ducsuibot/FPGA-Based-Driver-Drowsiness-Detection-using-BNN-Kiwi-1P5-Sonix-MCU/MCU_Sonix_Buzzer_WD/Source/Readme/readme.txt

/*
struct tree
	main.c: initial and main loop function
	PFPA.c: unused
	GPIO.c: initial gpio pin
	 WDT.c: initial watchdog with 250ms reset while do nothing
 utility.c: delay to set digital tube scan freuqency

 Segment.c: driver digital tube functions
 
 function:
	segment tube display "3210"
*/
