ducsuibot/FPGA-Based-Driver-Drowsiness-Detection-using-BNN-Kiwi-1P5-Sonix-MCU/Gowin_ROM.v

//Copyright (C)2014-2026 Gowin Semiconductor Corporation.
//All rights reserved.
//File Title: IP file
//Tool Version: V1.9.12.02_SP1 (64-bit)
//IP Version: 1.0
//Part Number: GW1N-LV1P5LQ100C6/I5
//Device: GW1N-1P5
//Created Time: Sun Apr 26 16:49:59 2026

module Gowin_ROM (dout, clk, oce, ce, reset, ad);

output [31:0] dout;
input clk;
input oce;
input ce;
input reset;
input [10:0] ad;

wire lut_f_0;
wire lut_f_1;
wire [15:0] prom_inst_0_dout_w;
wire [15:0] prom_inst_0_dout;
wire [15:0] prom_inst_1_dout_w;
wire [31:16] prom_inst_1_dout;
wire [31:0] prom_inst_2_dout;
wire dff_q_0;
wire gw_gnd;

assign gw_gnd = 1'b0;

LUT2 lut_inst_0 (
  .F(lut_f_0),
  .I0(ce),
  .I1(ad[10])
);
defparam lut_inst_0.INIT = 4'h2;
LUT3 lut_inst_1 (
  .F(lut_f_1),
  .I0(ce),
  .I1(ad[9]),
  .I2(ad[10])
);
defparam lut_inst_1.INIT = 8'h20;
pROM prom_inst_0 (
    .DO({prom_inst_0_dout_w[15:0],prom_inst_0_dout[15:0]}),
    .CLK(clk),
    .OCE(oce),
    .CE(lut_f_0),
    .RESET(reset),
    .AD({ad[9:0],gw_gnd,gw_gnd,gw_gnd,gw_gnd})
);

defparam prom_inst_0.READ_MODE = 1'b0;
defparam prom_inst_0.BIT_WIDTH = 16;
defparam prom_inst_0.RESET_MODE = "SYNC";
defparam prom_inst_0.INIT_RAM_00 = 256'hFFF0FE87FF69FE08FE16FF88FFB2FF01FE15FEFFFFD9FF47FE88FFBDFFF0FF78;
defparam prom_inst_0.INIT_RAM_01 = 256'h8003FED9FFBAFE0FFE12FFDEFE79FF33FE92FEFFFE1BFFB0FE37FEDEFE4BFEC0;
defparam prom_inst_0.INIT_RAM_02 = 256'h808BFF04FF90FE00FF29FE90FFE0FFA8FF14FFAFFF19FEA6FE80FFCFFE6DFF59;
defparam prom_inst_0.INIT_RAM_03 = 256'h809BFF58FF39FE2FFE2AFFB7FEBBFE27FE55FEF8FF33FEB3FEAFFFBBFF1FFF58;
defparam prom_inst_0.INIT_RAM_04 = 256'h8000FE6BFE9AFED6FEDDFE9FFEFFFE40FFD8FFFBFE10FF5EFE0EFE99FE80FEAE;
defparam prom_inst_0.INIT_RAM_05 = 256'h80DAFE32FEF5FEF4FF3DFF17FE66FFA5FF26FE08FECAFF24FE26FEFBFECBFEEE;
defparam prom_inst_0.INIT_RAM_06 = 256'h81EBFEA0FF00FF11FF39FF82FF27FE87FE00FF1EFECAFE20FE31FF3EFFCEFFCD;
defparam prom_inst_0.INIT_RAM_07 = 256'h8186FEC8FF09FF3FFE55FE43FF07FE43FE09FF4CFFCEFE20FEE3FE1CFF1EFF8B;
defparam prom_inst_0.INIT_RAM_08 = 256'h80F1FE1AFE42FFDEFF2FFE07FE25FF60FE0EFE40FEE1FF0AFE17FE23FEFAFEE3;
defparam prom_inst_0.INIT_RAM_09 = 256'h80C8FF11FED6FE18FF89FF87FE65FFA4FF17FE62FEC1FF32FE0BFEC3FE4AFECB;
defparam prom_inst_0.INIT_RAM_0A = 256'h8017FE91FEC7FE17FE85FE38FF20FE87FFC7FE78FF68FEE2FE1EFFF8FE1FFE8A;
defparam prom_inst_0.INIT_RAM_0B = 256'h8088FFB6FF20FF00FEB9FF97FE9FFF39FE31FF96FF08FF77FFABFEDDFE00FFB9;
defparam prom_inst_0.INIT_RAM_0C = 256'h8080FE75FED7FEC0FEABFEAFFE07FE4DFF85FE08FE40FE36FE57FE69FED9FE2F;
defparam prom_inst_0.INIT_RAM_0D = 256'h81B4FE0CFE44FF6FFEECFFC6FE83FED8FF5CFFA1FFA0FE4EFE57FE81FFDCFFA5;
defparam prom_inst_0.INIT_RAM_0E = 256'h80C1FFA3FF80FF29FE21FF87FE05FF32FE21FE19FF89FE24FF0BFE15FFC8FE5B;
defparam prom_inst_0.INIT_RAM_0F = 256'h81B7FE83FFC6FE21FE2FFF83FFDBFE49FE09FE32FF96FE24FEBAFFD7FFCAFFC3;
defparam prom_inst_0.INIT_RAM_10 = 256'h81CEFE18FF11FE23FF28FF02FF47FE83FE01FFBEFF88FE21FEABFF3EFFCEFF0B;
defparam prom_inst_0.INIT_RAM_11 = 256'h402628926D9C165039C8C80CE0C4604BEF13F93BC06AE46DC072E072402ED277;
defparam prom_inst_0.INIT_RAM_12 = 256'h0B9C0800580E5AF8FA039BD57D981C11CAE58E6C82F5A2EF2C6214000DABF0EA;
defparam prom_inst_0.INIT_RAM_13 = 256'h4626E457B77C15DE478C56654F9439CDBF89BF89CC92288001BA5898507B78DA;
defparam prom_inst_0.INIT_RAM_14 = 256'h2FBD8E0D160FE4EEECAAEE927D185D985289AFEF5644A7553B9DD7ECE264ABFB;
defparam prom_inst_0.INIT_RAM_15 = 256'hC4734D8BE066507212671247812CE679FE64B777BB7ED76EB2EE11EF9AB2EE9F;
defparam prom_inst_0.INIT_RAM_16 = 256'h49DB0F9D5BFFA26E22135F043081FDA00FBBCD8B1EB8BF94BC72F2EF8AC6AA4C;
defparam prom_inst_0.INIT_RAM_17 = 256'h46335165437CE77F01D30098508B40AA4F9C0EC040457870736FDBF3D3F00393;
defparam prom_inst_0.INIT_RAM_18 = 256'h2DF7048099B8192AE4E32C12299A04C019983B40E86340221142B5BA802A9662;
defparam prom_inst_0.INIT_RAM_19 = 256'h019A1998010909110D1B4A50705D1A61704239F0E1B4A99102568A6F92E7A267;
defparam prom_inst_0.INIT_RAM_1A = 256'hC422281A5E99B24039981900A5A80290C34BED73F269F71B45765164427FC677;
defparam prom_inst_0.INIT_RAM_1B = 256'h5D1C0640714C1F5154C63BF293F5811134D532EDC267E267B4761E002D99148A;
defparam prom_inst_0.INIT_RAM_1C = 256'h39C84380E8966200385BBDD2A8E3BFFB48F228F6AAEDDFF70190191840091C00;
defparam prom_inst_0.INIT_RAM_1D = 256'hD06671F2A5F01B192A57976D826FA267AD76149835B8DC2BE46264123D9B94C8;
defparam prom_inst_0.INIT_RAM_1E = 256'h574C52654D9A098A3989BF893E93398057D75ACF428D2A8D5D185A59C01C1969;
defparam prom_inst_0.INIT_RAM_1F = 256'hD83AEE106D985D98DBC9FBFFE247E2753B9CBBFCF6656BBF4E67A7F79576B5A5;
defparam prom_inst_0.INIT_RAM_20 = 256'hB649B61B50130000FE67EFE7BFF4F36DA2FBF9FF9EEAE49FADBC840F164B66EE;
defparam prom_inst_0.INIT_RAM_21 = 256'h5F88EBE356C6A6553F9D1BF4C567EBB3C6477DD5777135EE568C02656754917C;
defparam prom_inst_0.INIT_RAM_22 = 256'hA820B520BD6AD17AF2EE65A48EFAE58E2FBD8C0D0E0BFDE6DB3BE9917D985D98;
defparam prom_inst_0.INIT_RAM_23 = 256'hCCE32C123D9B104439D9AA8A485762B9A97AFDB2A46FB651407A4064332DE677;
defparam prom_inst_0.INIT_RAM_24 = 256'h5D185A00F9071178D04271F2C1F0BA1122470AED92E7A2672477109035B91FAA;
defparam prom_inst_0.INIT_RAM_25 = 256'h6AA7E5FFB71DBDD450A680847F987F981F88BF88FC920B820193190840890C91;
defparam prom_inst_0.INIT_RAM_26 = 256'h2FBDAC0D1E4F946EFCA870927D885D98D28DAB7FDA47E364135D13F5A2E4A1FB;
defparam prom_inst_0.INIT_RAM_27 = 256'h1C3457CD0ADC09823D889F893E832988FE2CE7E7FF64F77CE6ECA5BF8EBAE78F;
defparam prom_inst_0.INIT_RAM_28 = 256'hDABA68937D985D9858C8FFFFE666E5B53B5C53FDE67449BB4667EFFF156F55F7;
defparam prom_inst_0.INIT_RAM_29 = 256'h37197711977DC667FE6DEEE7BFE4F777F6E3F5BF92E6AC3F8DBC8C0F2E7EA46E;
defparam prom_inst_0.INIT_RAM_2A = 256'hF6E71186B199B91A4C82C8B29C3B42D43D987F2DAE6F6D59FCBB499AB4697609;
defparam prom_inst_0.INIT_RAM_2B = 256'h01FB1898408940C9671CE784F0531868F0667BF201E6AAF30B1D8366826FE667;
defparam prom_inst_0.INIT_RAM_2C = 256'h3B9D13ECC2E4E9BB4227673B9760B795562702655F914984998DBF8B7C9219C0;
defparam prom_inst_0.INIT_RAM_2D = 256'hF2E6A9FF2E99E7BF2FBD8E0D0A4BA46EDD3AEE126D905D9842C8EFFBDF46E655;
defparam prom_inst_0.INIT_RAM_2E = 256'hC667D17FB7BC9D9EEC27A0C41FD649AC1F89BF87589A3984FE66B777BB7CD3EC;
defparam prom_inst_0.INIT_RAM_2F = 256'h0FB9CC2D000FD76E393844102D185998D649E9FFC6462A751FDCD3E4C0654FBB;
defparam prom_inst_0.INIT_RAM_30 = 256'h798D36450704D162A208E708A5033205FE67A66FB3EED2EEB2FFF8FD96E3E4BF;
defparam prom_inst_0.INIT_RAM_31 = 256'hD078ED307C885D98D28DAFF75F850DF51B5D93CDE056DE774686D75A371CFDD9;
defparam prom_inst_0.INIT_RAM_32 = 256'hFD980D983E9B3982A86AE5A8EDEAF8FBE2E6A5A4BAB6AC37AFB1A409264E8766;
defparam prom_inst_0.INIT_RAM_33 = 256'hDDEDE9FFCFF6404FD224B6D4F455B57B73942880771F1D1CDB9697E55FD8BF84;
defparam prom_inst_0.INIT_RAM_34 = 256'hFE2CC767FF740365B266E1BFA7F2879F8899AC0C6C0F606EE27EE6736D825D90;
defparam prom_inst_0.INIT_RAM_35 = 256'hC4E2251A1F9A5448B0181A48EA53A2422B90FCBBAAE7FAFE48F658F6AAEDDCBB;
defparam prom_inst_0.INIT_RAM_36 = 256'h51149CC968151841D042F3F2E1F16A992277DE6D9267A2678676041C0539594B;
defparam prom_inst_0.INIT_RAM_37 = 256'h34C831046284022CCA00AC3AA023E225C27FC0631268C67F76371BCF4A850B15;
defparam prom_inst_0.INIT_RAM_38 = 256'h904691F23B940B31AB4F434FC277A267150404001C9955CACC230CB22F1D1C01;
defparam prom_inst_0.INIT_RAM_39 = 256'h4C9B718BAAE7B8F6CAF6ABF5AEADFEFD01D35018588B4D995D1C1A80511C1868;
defparam prom_inst_0.INIT_RAM_3A = 256'h0206E9E58276E26283660598A239C263A2130C1ADFBBA058A108DA8660930002;
defparam prom_inst_0.INIT_RAM_3B = 256'hB9892F9808981988561E1B475B850E851D50581B3D111BC0B046F3C6A1B12999;
defparam prom_inst_0.INIT_RAM_3C = 256'h6080DF6FD767301E5300F2C4E0774FBBE6B7FFFFD7E9F467044C924C5BF5BEF3;
defparam prom_inst_0.INIT_RAM_3D = 256'hFF44B7F7F266C6FE8AE9E599E6E7EE2643B6AC3DDA4D65ECFC7F87A30D0B399D;
defparam prom_inst_0.INIT_RAM_3E = 256'hB25D935DF6672AF37E97491F358D9DDAD777424433102709B719970815181100;
defparam prom_inst_0.INIT_RAM_3F = 256'hF262A9B68FFBEE968DBDA60FAA4FE464F628F0322D905D984548EB77D6EEC275;

pROM prom_inst_1 (
    .DO({prom_inst_1_dout_w[15:0],prom_inst_1_dout[31:16]}),
    .CLK(clk),
    .OCE(oce),
    .CE(lut_f_0),
    .RESET(reset),
    .AD({ad[9:0],gw_gnd,gw_gnd,gw_gnd,gw_gnd})
);

defparam prom_inst_1.READ_MODE = 1'b0;
defparam prom_inst_1.BIT_WIDTH = 16;
defparam prom_inst_1.RESET_MODE = "SYNC";
defparam prom_inst_1.INIT_RAM_00 = 256'h8006800580058004800580048006800580058007800680058004800680068005;
defparam prom_inst_1.INIT_RAM_01 = 256'h4F45000000000000000000000000000000000000000000000000000000000000;
defparam prom_inst_1.INIT_RAM_02 = 256'h5545000000000000000000000000000000000000000000000000000000000000;
defparam prom_inst_1.INIT_RAM_03 = 256'h5546000000000000000000000000000000000000000000000000000000000000;
defparam prom_inst_1.INIT_RAM_04 = 256'h5044000000000000000000000000000000000000000000000000000000000000;
defparam prom_inst_1.INIT_RAM_05 = 256'h5145000000000000000000000000000000000000000000000000000000000000;
defparam prom_inst_1.INIT_RAM_06 = 256'h574A000000000000000000000000000000000000000000000000000000000000;
defparam prom_inst_1.INIT_RAM_07 = 256'h5146000000000000000000000000000000000000000000000000000000000000;
defparam prom_inst_1.INIT_RAM_08 = 256'h5144000000000000000000000000000000000000000000000000000000000000;
defparam prom_inst_1.INIT_RAM_09 = 256'h4E43000000000000000000000000000000000000000000000000000000000000;
defparam prom_inst_1.INIT_RAM_0A = 256'h5144000000000000000000000000000000000000000000000000000000000000;
defparam prom_inst_1.INIT_RAM_0B = 256'h5045000000000000000000000000000000000000000000000000000000000000;
defparam prom_inst_1.INIT_RAM_0C = 256'h4C40000000000000000000000000000000000000000000000000000000000000;
defparam prom_inst_1.INIT_RAM_0D = 256'h4F44000000000000000000000000000000000000000000000000000000000000;
defparam prom_inst_1.INIT_RAM_0E = 256'h5145000000000000000000000000000000000000000000000000000000000000;
defparam prom_inst_1.INIT_RAM_0F = 256'h5344000000000000000000000000000000000000000000000000000000000000;
defparam prom_inst_1.INIT_RAM_10 = 256'h5748000000000000000000000000000000000000000000000000000000000000;
defparam prom_inst_1.INIT_RAM_11 = 256'h8108810881088108810881088108810881088108810881088108810881088108;
defparam prom_inst_1.INIT_RAM_12 = 256'h8108810881088108810881088108810881088108810881088108810881088108;
defparam prom_inst_1.INIT_RAM_13 = 256'h8138813881388138813881388138813881388138813881388108810881088108;
defparam prom_inst_1.INIT_RAM_14 = 256'h8138813881388138813881388138813881388138813881388138813881388138;
defparam prom_inst_1.INIT_RAM_15 = 256'h8131813181318131813181318131813181388138813881388138813881388138;
defparam prom_inst_1.INIT_RAM_16 = 256'h8131813181318131813181318131813181318131813181318131813181318131;
defparam prom_inst_1.INIT_RAM_17 = 256'h80F880F880F880F8813181318131813181318131813181318131813181318131;
defparam prom_inst_1.INIT_RAM_18 = 256'h80F880F880F880F880F880F880F880F880F880F880F880F880F880F880F880F8;
defparam prom_inst_1.INIT_RAM_19 = 256'h80F880F880F880F880F880F880F880F880F880F880F880F880F880F880F880F8;
defparam prom_inst_1.INIT_RAM_1A = 256'h80F880F880F880F880F880F880F880F880F880F880F880F880F880F880F880F8;
defparam prom_inst_1.INIT_RAM_1B = 256'h80F880F880F880F880F880F880F880F880F880F880F880F880F880F880F880F8;
defparam prom_inst_1.INIT_RAM_1C = 256'h81188118811881188118811881188118811881188118811880F880F880F880F8;
defparam prom_inst_1.INIT_RAM_1D = 256'h8118811881188118811881188118811881188118811881188118811881188118;
defparam prom_inst_1.INIT_RAM_1E = 256'h8144814481448144814481448144814481188118811881188118811881188118;
defparam prom_inst_1.INIT_RAM_1F = 256'h8144814481448144814481448144814481448144814481448144814481448144;
defparam prom_inst_1.INIT_RAM_20 = 256'h8133813381338133814481448144814481448144814481448144814481448144;
defparam prom_inst_1.INIT_RAM_21 = 256'h8133813381338133813381338133813381338133813381338133813381338133;
defparam prom_inst_1.INIT_RAM_22 = 256'h8133813381338133813381338133813381338133813381338133813381338133;
defparam prom_inst_1.INIT_RAM_23 = 256'h8101810181018101810181018101810181018101810181018101810181018101;
defparam prom_inst_1.INIT_RAM_24 = 256'h8101810181018101810181018101810181018101810181018101810181018101;
defparam prom_inst_1.INIT_RAM_25 = 256'h8127812781278127812781278127812781278127812781278101810181018101;
defparam prom_inst_1.INIT_RAM_26 = 256'h8127812781278127812781278127812781278127812781278127812781278127;
defparam prom_inst_1.INIT_RAM_27 = 256'h8144814481448144814481448144814481278127812781278127812781278127;
defparam prom_inst_1.INIT_RAM_28 = 256'h8144814481448144814481448144814481448144814481448144814481448144;
defparam prom_inst_1.INIT_RAM_29 = 256'h8124812481248124814481448144814481448144814481448144814481448144;
defparam prom_inst_1.INIT_RAM_2A = 256'h8124812481248124812481248124812481248124812481248124812481248124;
defparam prom_inst_1.INIT_RAM_2B = 256'h8124812481248124812481248124812481248124812481248124812481248124;
defparam prom_inst_1.INIT_RAM_2C = 256'h8128812881288128812881288128812881288128812881288128812881288128;
defparam prom_inst_1.INIT_RAM_2D = 256'h8128812881288128812881288128812881288128812881288128812881288128;
defparam prom_inst_1.INIT_RAM_2E = 256'h814E814E814E814E814E814E814E814E814E814E814E814E8128812881288128;
defparam prom_inst_1.INIT_RAM_2F = 256'h814E814E814E814E814E814E814E814E814E814E814E814E814E814E814E814E;
defparam prom_inst_1.INIT_RAM_30 = 256'h81348134813481348134813481348134814E814E814E814E814E814E814E814E;
defparam prom_inst_1.INIT_RAM_31 = 256'h8134813481348134813481348134813481348134813481348134813481348134;
defparam prom_inst_1.INIT_RAM_32 = 256'h812A812A812A812A813481348134813481348134813481348134813481348134;
defparam prom_inst_1.INIT_RAM_33 = 256'h812A812A812A812A812A812A812A812A812A812A812A812A812A812A812A812A;
defparam prom_inst_1.INIT_RAM_34 = 256'h812A812A812A812A812A812A812A812A812A812A812A812A812A812A812A812A;
defparam prom_inst_1.INIT_RAM_35 = 256'h811B811B811B811B811B811B811B811B811B811B811B811B811B811B811B811B;
defparam prom_inst_1.INIT_RAM_36 = 256'h811B811B811B811B811B811B811B811B811B811B811B811B811B811B811B811B;
defparam prom_inst_1.INIT_RAM_37 = 256'h80F980F980F980F980F980F980F980F980F980F980F980F9811B811B811B811B;
defparam prom_inst_1.INIT_RAM_38 = 256'h80F980F980F980F980F980F980F980F980F980F980F980F980F980F980F980F9;
defparam prom_inst_1.INIT_RAM_39 = 256'h8113811381138113811381138113811380F980F980F980F980F980F980F980F9;
defparam prom_inst_1.INIT_RAM_3A = 256'h8113811381138113811381138113811381138113811381138113811381138113;
defparam prom_inst_1.INIT_RAM_3B = 256'h8145814581458145811381138113811381138113811381138113811381138113;
defparam prom_inst_1.INIT_RAM_3C = 256'h8145814581458145814581458145814581458145814581458145814581458145;
defparam prom_inst_1.INIT_RAM_3D = 256'h8145814581458145814581458145814581458145814581458145814581458145;
defparam prom_inst_1.INIT_RAM_3E = 256'h8128812881288128812881288128812881288128812881288128812881288128;
defparam prom_inst_1.INIT_RAM_3F = 256'h8128812881288128812881288128812881288128812881288128812881288128;

pROM prom_inst_2 (
    .DO(prom_inst_2_dout[31:0]),
    .CLK(clk),
    .OCE(oce),
    .CE(lut_f_1),
    .RESET(reset),
    .AD({ad[8:0],gw_gnd,gw_gnd,gw_gnd,gw_gnd,gw_gnd})
);

defparam prom_inst_2.READ_MODE = 1'b0;
defparam prom_inst_2.BIT_WIDTH = 32;
defparam prom_inst_2.RESET_MODE = "SYNC";
defparam prom_inst_2.INIT_RAM_00 = 256'h8110D076811020768110226F8110F67F8128A8688128E5308128A1728128F5E3;
defparam prom_inst_2.INIT_RAM_01 = 256'h81109DC88110E1AA8110EAA381104A658110ABDA81103DCF8110A2628110F474;
defparam prom_inst_2.INIT_RAM_02 = 256'h8110A577811054808110292B81105DAB8110C48281102C1281100A9A81105242;
defparam prom_inst_2.INIT_RAM_03 = 256'h8110D042811031F28110F1B581100B91811082578110D6E5811082EF8110A267;
defparam prom_inst_2.INIT_RAM_04 = 256'h8110207381101118811008898110089981101D9981105C508110E055811018C8;
defparam prom_inst_2.INIT_RAM_05 = 256'h813A1044813A0044813A7F98813A5989813A1D88813ADF98813ADC90813A0990;
defparam prom_inst_2.INIT_RAM_06 = 256'h813A1BFC813A936C813AE0F4813A687B813A6717813ADDBF813ABCD9813A1D95;
defparam prom_inst_2.INIT_RAM_07 = 256'h813AAC3A813AE533813A6D88813A5D98813AFAC8813AE17F813AE647813A65BD;
defparam prom_inst_2.INIT_RAM_08 = 256'h813AFEE3813AA9BF813A86FB813AA73E813AAD3F813AAC0F813A9E6F813AE66E;
defparam prom_inst_2.INIT_RAM_09 = 256'h812BAA89812BBF89812B2F92812B0B80813AFE24813AE6F7813AFEF6813AFBE6;
defparam prom_inst_2.INIT_RAM_0A = 256'h812B4E67812B4975812B1038812B154E812B5747812B8604812B5FD0812BAB8D;
defparam prom_inst_2.INIT_RAM_0B = 256'h812BD125812B8DFF812BDA66812BB6F5812B335D812BD7DD812BC474812B29FA;
defparam prom_inst_2.INIT_RAM_0C = 256'h812B2DBD812B2E0D812B4859812B2ECC812BFDA8812B6890812B2D18812B5D98;
defparam prom_inst_2.INIT_RAM_0D = 256'h812BFE64812BA767812BBF76812B92BF812B8B7B812B591F812B8AF2812BE59F;
defparam prom_inst_2.INIT_RAM_0E = 256'h8147C0A68147E665814767748147303A8147800081472704814780068147733F;
defparam prom_inst_2.INIT_RAM_0F = 256'h8147F11C814733D48147C7F78147FA778147EAF48147B12D8147B7778147D7FF;
defparam prom_inst_2.INIT_RAM_10 = 256'h81475FBD814790AB8147ED0381475D998147C16A8147EF77814733848147DFC4;
defparam prom_inst_2.INIT_RAM_11 = 256'h8147F6678147EDB48147AA7E8147619E8147EBFA8147A42D8147106E8147E5E6;
defparam prom_inst_2.INIT_RAM_12 = 256'h811B5EF6811B48F6811BA9E9811BEEBF8147A8688147F4208147FCA28147F5B2;
defparam prom_inst_2.INIT_RAM_13 = 256'h811BB998811B98CA811B4872811B28F1811BEBB8811BFCBB811BA8A3811BBFF3;
defparam prom_inst_2.INIT_RAM_14 = 256'h811BA73A811B4008811B219B811B7BAA811BCCE2811B2492811B2C9B811B5A88;
defparam prom_inst_2.INIT_RAM_15 = 256'h811BD046811B71F0811B81F1811B4999811B265E811B82ED811BD26F811BA2E7;
defparam prom_inst_2.INIT_RAM_16 = 256'h811B57DD811B5B5F811B429F811B2F87811B1D9D811B0649811B4D0C811B18F1;
defparam prom_inst_2.INIT_RAM_17 = 256'h812ABA94812AADB9812AAAEE812AC8FE812A68FE812A58F6812AD8EF812ADCFD;
defparam prom_inst_2.INIT_RAM_18 = 256'h812A84E6812A8932812ABD9F812AF00C812A31D9812AF3D0812AEA6B812AE2BD;
defparam prom_inst_2.INIT_RAM_19 = 256'h812A9E57812AD667812A83EF812AA2E7812A66A7812A6718812A3D99812A5D6A;
defparam prom_inst_2.INIT_RAM_1A = 256'h812A7D9C812A0EE9812A6D45812A19C0812AD243812A9BF2812A03E7812A8A39;
defparam prom_inst_2.INIT_RAM_1B = 256'h810000668100F47F8100C4688100E22F812A5797812A5ACF812A4A8D812A6FDD;
defparam prom_inst_2.INIT_RAM_1C = 256'h8100B8D981008A8A8100CAC381004262810082D68100642E8100827A8100A472;
defparam prom_inst_2.INIT_RAM_1D = 256'h810007BC81002400810034998100181B8100CC23810048B28100BA2881006001;
defparam prom_inst_2.INIT_RAM_1E = 256'h81007AC88100B3C58100FD95810060538100B4988100D6EF810082E78100A266;
defparam prom_inst_2.INIT_RAM_1F = 256'h810008108100015081000D5981000D108100099E810052468100391C81001BC9;
defparam prom_inst_2.INIT_RAM_20 = 256'h811037F68110AD9A811098A38110FEB5811048F6811048F781105AF38110CFFF;
defparam prom_inst_2.INIT_RAM_21 = 256'h8110806381102D1381103DA98110144C811039C88110C08881104BF2811043C6;
defparam prom_inst_2.INIT_RAM_22 = 256'h81102BD68110A8EF811082E78110A267811024B68110000881100D988110C08A;
defparam prom_inst_2.INIT_RAM_23 = 256'h81104D1081105A098110156D81101A698110F6428110DBD08110B99481101399;
defparam prom_inst_2.INIT_RAM_24 = 256'h813C1F89813CEF89813C5D92813C19D88110579F81104AC78110631D81106FD5;
defparam prom_inst_2.INIT_RAM_25 = 256'h813C66A7813CFEF7813C3D50813CBD52813C546D813C80A8813C7F99813C3B81;
defparam prom_inst_2.INIT_RAM_26 = 256'h813C5380813CC36F813CDA65813C1355813C3BD9813CD7ED813CC444813C6FBF;
defparam prom_inst_2.INIT_RAM_27 = 256'h813C4D9D813C660D813CCC5A813CCF6E813C79B9813C3910813C3D08813C5D18;
defparam prom_inst_2.INIT_RAM_28 = 256'h813CFEEC813CA777813CB766813CF736813CFEE6813CA3FF813CBFAA813CE7BE;
defparam prom_inst_2.INIT_RAM_29 = 256'h81180F228118FDDB8118B02E81180045811865778118E66F8118F76F8118C77F;
defparam prom_inst_2.INIT_RAM_2A = 256'h8118C4E28118A08281183C9A8118468081185DD981188C288118882281184A42;
defparam prom_inst_2.INIT_RAM_2B = 256'h8118005C8118256F811892ED8118A2E78118AE328118448081188DB981187CB0;
defparam prom_inst_2.INIT_RAM_2C = 256'h8118090C81184A028118F555811839798118564E811819D0811889B08118DB91;
defparam prom_inst_2.INIT_RAM_2D = 256'h81035267810340738103372D8103873B811809D3811801C88118000B8118181B;
defparam prom_inst_2.INIT_RAM_2E = 256'h81033D988103BF8C81036AB58103424981032B988103098A8103A06A81039477;
defparam prom_inst_2.INIT_RAM_2F = 256'h8103087781031C8081032D3881031D8A8103C0238103AC1A81032D9881031400;
defparam prom_inst_2.INIT_RAM_30 = 256'h8103D243810339D2810359B18103CA53810326448103FEED810392FF8103A267;
defparam prom_inst_2.INIT_RAM_31 = 256'h8103019B81031990810340918103608181034484810386E08103F10581031BC0;
defparam prom_inst_2.INIT_RAM_32 = 256'h000000000000000000000000000000000000000000000000801021D88010F6C2;

DFFE dff_inst_0 (
  .Q(dff_q_0),
  .D(ad[10]),
  .CLK(clk),
  .CE(ce)
);
MUX2 mux_inst_2 (
  .O(dout[0]),
  .I0(prom_inst_0_dout[0]),
  .I1(prom_inst_2_dout[0]),
  .S0(dff_q_0)
);
MUX2 mux_inst_5 (
  .O(dout[1]),
  .I0(prom_inst_0_dout[1]),
  .I1(prom_inst_2_dout[1]),
  .S0(dff_q_0)
);
MUX2 mux_inst_8 (
  .O(dout[2]),
  .I0(prom_inst_0_dout[2]),
  .I1(prom_inst_2_dout[2]),
  .S0(dff_q_0)
);
MUX2 mux_inst_11 (
  .O(dout[3]),
  .I0(prom_inst_0_dout[3]),
  .I1(prom_inst_2_dout[3]),
  .S0(dff_q_0)
);
MUX2 mux_inst_14 (
  .O(dout[4]),
  .I0(prom_inst_0_dout[4]),
  .I1(prom_inst_2_dout[4]),
  .S0(dff_q_0)
);
MUX2 mux_inst_17 (
  .O(dout[5]),
  .I0(prom_inst_0_dout[5]),
  .I1(prom_inst_2_dout[5]),
  .S0(dff_q_0)
);
MUX2 mux_inst_20 (
  .O(dout[6]),
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
  .I1(prom_inst_2_dout[29]),
  .S0(dff_q_0)
);
MUX2 mux_inst_92 (
  .O(dout[30]),
  .I0(prom_inst_1_dout[30]),
  .I1(prom_inst_2_dout[30]),
  .S0(dff_q_0)
);
MUX2 mux_inst_95 (
  .O(dout[31]),
  .I0(prom_inst_1_dout[31]),
  .I1(prom_inst_2_dout[31]),
  .S0(dff_q_0)
);
endmodule //Gowin_ROM
