ducsuibot/FPGA-Based-Driver-Drowsiness-Detection-using-BNN-Kiwi-1P5-Sonix-MCU/RTL_EYE/weight_rom.v

// // `timescale 1ns / 1ps
// //
// // module weight_rom (
// //     input  wire        clk,
// //     input  wire [11:0] addr, 
// //     output reg  [31:0] data  
// // );
// //     reg [31:0] flash_mem [0:1425];
// //
// //     initial begin
// //         $readmemh("bnn_weights_sim.txt", flash_mem);
// //     end
// //
// //     always @(posedge clk) begin
// //         data <= flash_mem[addr];
// //     end
// //
// // endmodule
// //
// //
`timescale 1ns / 1ps

module weight_rom (
   input  wire        clk,
   input  wire [11:0] addr, 
   output wire [31:0] data  // Đổi thành wire vì data được lái bởi IP Core
);

   // Gọi IP Core pROM của Gowin vừa tạo
   // (Kiểm tra file gowin_prom.v được sinh ra để xem chính xác tên cổng)
   gowin_rom u_gowin_prom (
       .clk(clk),
       .oce(1'b1),     // Output Clock Enable (Luôn bật)
       .ce(1'b1),      // Chip Enable (Luôn bật)
       .reset(1'b0),   // Không dùng reset
       .ad(addr[10:0]),       // Địa chỉ 12-bit
       .dout(data)     // Dữ liệu đầu ra 32-bit (đã có sẵn độ trễ 1 chu kỳ)
   );

endmodule

//  `timescale 1ns / 1ps

//  module weight_rom (
//      input  wire        clk,
//      input  wire [11:0] addr, 
//      output reg  [31:0] data  
//  );

//      always @(posedge clk) begin
//          case (addr)
//              12'd0   : data <= 32'h8005FF17;
//              12'd1   : data <= 32'h8005FF70;
//              12'd2   : data <= 32'h8006FE28;
//              12'd3   : data <= 32'h8006FEF8;
//              12'd4   : data <= 32'h8005FEDF;
//              12'd5   : data <= 32'h8006FECE;
//              12'd6   : data <= 32'h8006FFD8;
//              12'd7   : data <= 32'h8006FFB7;
//              12'd8   : data <= 32'h8006FF75;
//              12'd9   : data <= 32'h8005FE1A;
//              12'd10  : data <= 32'h8006FFF8;
//              12'd11  : data <= 32'h8005FFEB;
//              12'd12  : data <= 32'h8006FFC0;
//              12'd13  : data <= 32'h8006FFE4;
//              12'd14  : data <= 32'h8005FEC2;
//              12'd15  : data <= 32'h8006FFF7;
//              12'd16  : data <= 32'h0000FF41;
//              12'd17  : data <= 32'h0000FF90;
//              12'd18  : data <= 32'h0000FF48;
//              12'd19  : data <= 32'h0000FEF5;
//              12'd20  : data <= 32'h0000FEB6;
//              12'd21  : data <= 32'h0000FF3C;
//              12'd22  : data <= 32'h0000FFF4;
//              12'd23  : data <= 32'h0000FFB8;
//              12'd24  : data <= 32'h0000FEF2;
//              12'd25  : data <= 32'h0000FE60;
//              12'd26  : data <= 32'h0000FF92;
//              12'd27  : data <= 32'h0000FFE6;
//              12'd28  : data <= 32'h0000FE88;
//              12'd29  : data <= 32'h0000FEC8;
//              12'd30  : data <= 32'h0000FEE8;
//              12'd31  : data <= 32'h514481F0;
//              12'd32  : data <= 32'h0000FF93;
//              12'd33  : data <= 32'h0000FE00;
//              12'd34  : data <= 32'h0000FEDB;
//              12'd35  : data <= 32'h0000FE3C;
//              12'd36  : data <= 32'h0000FF21;
//              12'd37  : data <= 32'h0000FF0B;
//              12'd38  : data <= 32'h0000FF96;
//              12'd39  : data <= 32'h0000FF03;
//              12'd40  : data <= 32'h0000FF93;
//              12'd41  : data <= 32'h0000FE8F;
//              12'd42  : data <= 32'h0000FF3C;
//              12'd43  : data <= 32'h0000FFB6;
//              12'd44  : data <= 32'h0000FEBD;
//              12'd45  : data <= 32'h0000FE0F;
//              12'd46  : data <= 32'h0000FE9E;
//              12'd47  : data <= 32'h4E468187;
//              12'd48  : data <= 32'h0000FF25;
//              12'd49  : data <= 32'h0000FE03;
//              12'd50  : data <= 32'h0000FE87;
//              12'd51  : data <= 32'h0000FE0C;
//              12'd52  : data <= 32'h0000FE48;
//              12'd53  : data <= 32'h0000FE59;
//              12'd54  : data <= 32'h0000FE68;
//              12'd55  : data <= 32'h0000FF41;
//              12'd56  : data <= 32'h0000FF24;
//              12'd57  : data <= 32'h0000FF80;
//              12'd58  : data <= 32'h0000FE68;
//              12'd59  : data <= 32'h0000FE4C;
//              12'd60  : data <= 32'h0000FF86;
//              12'd61  : data <= 32'h0000FF3B;
//              12'd62  : data <= 32'h0000FF95;
//              12'd63  : data <= 32'h50468063;
//              12'd64  : data <= 32'h0000FEA8;
//              12'd65  : data <= 32'h0000FEE3;
//              12'd66  : data <= 32'h0000FEC8;
//              12'd67  : data <= 32'h0000FF84;
//              12'd68  : data <= 32'h0000FF11;
//              12'd69  : data <= 32'h0000FE0C;
//              12'd70  : data <= 32'h0000FF87;
//              12'd71  : data <= 32'h0000FEB9;
//              12'd72  : data <= 32'h0000FF8B;
//              12'd73  : data <= 32'h0000FE6E;
//              12'd74  : data <= 32'h0000FF87;
//              12'd75  : data <= 32'h0000FF86;
//              12'd76  : data <= 32'h0000FE63;
//              12'd77  : data <= 32'h0000FECA;
//              12'd78  : data <= 32'h0000FEFB;
//              12'd79  : data <= 32'h52478183;
//              12'd80  : data <= 32'h0000FE38;
//              12'd81  : data <= 32'h0000FEE3;
//              12'd82  : data <= 32'h0000FF11;
//              12'd83  : data <= 32'h0000FF47;
//              12'd84  : data <= 32'h0000FE06;
//              12'd85  : data <= 32'h0000FE1E;
//              12'd86  : data <= 32'h0000FECA;
//              12'd87  : data <= 32'h0000FE1A;
//              12'd88  : data <= 32'h0000FEDE;
//              12'd89  : data <= 32'h0000FE2C;
//              12'd90  : data <= 32'h0000FF83;
//              12'd91  : data <= 32'h0000FFDE;
//              12'd92  : data <= 32'h0000FE2B;
//              12'd93  : data <= 32'h0000FE4B;
//              12'd94  : data <= 32'h0000FE11;
//              12'd95  : data <= 32'h524580CE;
//              12'd96  : data <= 32'h0000FEB3;
//              12'd97  : data <= 32'h0000FE7D;
//              12'd98  : data <= 32'h0000FE5E;
//              12'd99  : data <= 32'h0000FFA1;
//              12'd100 : data <= 32'h0000FF2D;
//              12'd101 : data <= 32'h0000FE00;
//              12'd102 : data <= 32'h0000FFA7;
//              12'd103 : data <= 32'h0000FF3B;
//              12'd104 : data <= 32'h0000FF91;
//              12'd105 : data <= 32'h0000FE09;
//              12'd106 : data <= 32'h0000FFA3;
//              12'd107 : data <= 32'h0000FFA6;
//              12'd108 : data <= 32'h0000FE7C;
//              12'd109 : data <= 32'h0000FE44;
//              12'd110 : data <= 32'h0000FEDF;
//              12'd111 : data <= 32'h54498121;
//              12'd112 : data <= 32'h0000FFE0;
//              12'd113 : data <= 32'h0000FE7B;
//              12'd114 : data <= 32'h0000FEC0;
//              12'd115 : data <= 32'h0000FF69;
//              12'd116 : data <= 32'h0000FE58;
//              12'd117 : data <= 32'h0000FE5C;
//              12'd118 : data <= 32'h0000FE28;
//              12'd119 : data <= 32'h0000FEE0;
//              12'd120 : data <= 32'h0000FF48;
//              12'd121 : data <= 32'h0000FE67;
//              12'd122 : data <= 32'h0000FE79;
//              12'd123 : data <= 32'h0000FE7C;
//              12'd124 : data <= 32'h0000FE3B;
//              12'd125 : data <= 32'h0000FE1C;
//              12'd126 : data <= 32'h0000FE26;
//              12'd127 : data <= 32'h55468040;
//              12'd128 : data <= 32'h0000FE0B;
//              12'd129 : data <= 32'h0000FE5A;
//              12'd130 : data <= 32'h0000FE59;
//              12'd131 : data <= 32'h0000FF42;
//              12'd132 : data <= 32'h0000FEB6;
//              12'd133 : data <= 32'h0000FF8B;
//              12'd134 : data <= 32'h0000FFA2;
//              12'd135 : data <= 32'h0000FFA7;
//              12'd136 : data <= 32'h0000FFF3;
//              12'd137 : data <= 32'h0000FE1B;
//              12'd138 : data <= 32'h0000FEE2;
//              12'd139 : data <= 32'h0000FFA5;
//              12'd140 : data <= 32'h0000FE4C;
//              12'd141 : data <= 32'h0000FE59;
//              12'd142 : data <= 32'h0000FE4A;
//              12'd143 : data <= 32'h53468172;
//              12'd144 : data <= 32'h0000FEFD;
//              12'd145 : data <= 32'h0000FFC5;
//              12'd146 : data <= 32'h0000FFB4;
//              12'd147 : data <= 32'h0000FEDB;
//              12'd148 : data <= 32'h0000FE99;
//              12'd149 : data <= 32'h0000FEDE;
//              12'd150 : data <= 32'h0000FE63;
//              12'd151 : data <= 32'h0000FE48;
//              12'd152 : data <= 32'h0000FE48;
//              12'd153 : data <= 32'h0000FEFF;
//              12'd154 : data <= 32'h0000FE73;
//              12'd155 : data <= 32'h0000FEF3;
//              12'd156 : data <= 32'h0000FFE6;
//              12'd157 : data <= 32'h0000FE6E;
//              12'd158 : data <= 32'h0000FE86;
//              12'd159 : data <= 32'h51458048;
//              12'd160 : data <= 32'h0000FF64;
//              12'd161 : data <= 32'h0000FE37;
//              12'd162 : data <= 32'h0000FF06;
//              12'd163 : data <= 32'h0000FE68;
//              12'd164 : data <= 32'h0000FE58;
//              12'd165 : data <= 32'h0000FE48;
//              12'd166 : data <= 32'h0000FE6D;
//              12'd167 : data <= 32'h0000FE40;
//              12'd168 : data <= 32'h0000FE2C;
//              12'd169 : data <= 32'h0000FF83;
//              12'd170 : data <= 32'h0000FE4D;
//              12'd171 : data <= 32'h0000FE48;
//              12'd172 : data <= 32'h0000FE17;
//              12'd173 : data <= 32'h0000FF3F;
//              12'd174 : data <= 32'h0000FF94;
//              12'd175 : data <= 32'h51448042;
//              12'd176 : data <= 32'h0000FE6A;
//              12'd177 : data <= 32'h0000FE66;
//              12'd178 : data <= 32'h0000FE66;
//              12'd179 : data <= 32'h0000FE03;
//              12'd180 : data <= 32'h0000FE9B;
//              12'd181 : data <= 32'h0000FE57;
//              12'd182 : data <= 32'h0000FE83;
//              12'd183 : data <= 32'h0000FE88;
//              12'd184 : data <= 32'h0000FEC9;
//              12'd185 : data <= 32'h0000FE7E;
//              12'd186 : data <= 32'h0000FE01;
//              12'd187 : data <= 32'h0000FFDB;
//              12'd188 : data <= 32'h0000FF66;
//              12'd189 : data <= 32'h0000FE44;
//              12'd190 : data <= 32'h0000FE4E;
//              12'd191 : data <= 32'h574A80C8;
//              12'd192 : data <= 32'h0000FFA8;
//              12'd193 : data <= 32'h0000FF78;
//              12'd194 : data <= 32'h0000FFA7;
//              12'd195 : data <= 32'h0000FE73;
//              12'd196 : data <= 32'h0000FFC8;
//              12'd197 : data <= 32'h0000FED4;
//              12'd198 : data <= 32'h0000FE6A;
//              12'd199 : data <= 32'h0000FFEA;
//              12'd200 : data <= 32'h0000FE70;
//              12'd201 : data <= 32'h0000FE87;
//              12'd202 : data <= 32'h0000FE71;
//              12'd203 : data <= 32'h0000FE6D;
//              12'd204 : data <= 32'h0000FE3B;
//              12'd205 : data <= 32'h0000FF74;
//              12'd206 : data <= 32'h0000FE22;
//              12'd207 : data <= 32'h50448066;
//              12'd208 : data <= 32'h0000FE83;
//              12'd209 : data <= 32'h0000FE61;
//              12'd210 : data <= 32'h0000FE2A;
//              12'd211 : data <= 32'h0000FFF0;
//              12'd212 : data <= 32'h0000FEB0;
//              12'd213 : data <= 32'h0000FE22;
//              12'd214 : data <= 32'h0000FE3A;
//              12'd215 : data <= 32'h0000FE19;
//              12'd216 : data <= 32'h0000FFC0;
//              12'd217 : data <= 32'h0000FE2F;
//              12'd218 : data <= 32'h0000FEF4;
//              12'd219 : data <= 32'h0000FF92;
//              12'd220 : data <= 32'h0000FE4D;
//              12'd221 : data <= 32'h0000FE70;
//              12'd222 : data <= 32'h0000FE36;
//              12'd223 : data <= 32'h54478097;
//              12'd224 : data <= 32'h0000FE43;
//              12'd225 : data <= 32'h0000FE4D;
//              12'd226 : data <= 32'h0000FE8B;
//              12'd227 : data <= 32'h0000FFDE;
//              12'd228 : data <= 32'h0000FFD6;
//              12'd229 : data <= 32'h0000FE3C;
//              12'd230 : data <= 32'h0000FE59;
//              12'd231 : data <= 32'h0000FEC1;
//              12'd232 : data <= 32'h0000FE46;
//              12'd233 : data <= 32'h0000FF8D;
//              12'd234 : data <= 32'h0000FFDE;
//              12'd235 : data <= 32'h0000FE08;
//              12'd236 : data <= 32'h0000FEEB;
//              12'd237 : data <= 32'h0000FE4F;
//              12'd238 : data <= 32'h0000FE0F;
//              12'd239 : data <= 32'h5044804E;
//              12'd240 : data <= 32'h0000FFE1;
//              12'd241 : data <= 32'h0000FFC6;
//              12'd242 : data <= 32'h0000FFA2;
//              12'd243 : data <= 32'h0000FE5B;
//              12'd244 : data <= 32'h0000FED9;
//              12'd245 : data <= 32'h0000FF83;
//              12'd246 : data <= 32'h0000FE79;
//              12'd247 : data <= 32'h0000FFC9;
//              12'd248 : data <= 32'h0000FE45;
//              12'd249 : data <= 32'h0000FF34;
//              12'd250 : data <= 32'h0000FF7B;
//              12'd251 : data <= 32'h0000FE3B;
//              12'd252 : data <= 32'h0000FF37;
//              12'd253 : data <= 32'h0000FF87;
//              12'd254 : data <= 32'h0000FF07;
//              12'd255 : data <= 32'h4D418048;
//              12'd256 : data <= 32'h0000FE5B;
//              12'd257 : data <= 32'h0000FE55;
//              12'd258 : data <= 32'h0000FFEE;
//              12'd259 : data <= 32'h0000FF23;
//              12'd260 : data <= 32'h0000FE03;
//              12'd261 : data <= 32'h0000FF8A;
//              12'd262 : data <= 32'h0000FE31;
//              12'd263 : data <= 32'h0000FE0F;
//              12'd264 : data <= 32'h0000FE49;
//              12'd265 : data <= 32'h0000FF69;
//              12'd266 : data <= 32'h0000FF03;
//              12'd267 : data <= 32'h0000FE3B;
//              12'd268 : data <= 32'h0000FE02;
//              12'd269 : data <= 32'h0000FE08;
//              12'd270 : data <= 32'h0000FE62;
//              12'd271 : data <= 32'h55498081;
//              12'd272 : data <= 32'h811F7FCB;
//              12'd273 : data <= 32'h811FFD5E;
//              12'd274 : data <= 32'h811F0DDB;
//              12'd275 : data <= 32'h811F8F88;
//              12'd276 : data <= 32'h811F0804;
//              12'd277 : data <= 32'h811FB69F;
//              12'd278 : data <= 32'h811F3627;
//              12'd279 : data <= 32'h811FF306;
//              12'd280 : data <= 32'h811FF77E;
//              12'd281 : data <= 32'h811FB679;
//              12'd282 : data <= 32'h811F9182;
//              12'd283 : data <= 32'h811FB7DD;
//              12'd284 : data <= 32'h811F856A;
//              12'd285 : data <= 32'h811F9235;
//              12'd286 : data <= 32'h811F3246;
//              12'd287 : data <= 32'h811FF246;
//              12'd288 : data <= 32'h811F0BEB;
//              12'd289 : data <= 32'h811FB0FA;
//              12'd290 : data <= 32'h811F49D0;
//              12'd291 : data <= 32'h811F8D11;
//              12'd292 : data <= 32'h811F86AD;
//              12'd293 : data <= 32'h811F8294;
//              12'd294 : data <= 32'h811F839E;
//              12'd295 : data <= 32'h811F0A39;
//              12'd296 : data <= 32'h811F7ABF;
//              12'd297 : data <= 32'h811F3042;
//              12'd298 : data <= 32'h811FEC78;
//              12'd299 : data <= 32'h811F08E9;
//              12'd300 : data <= 32'h811FA61E;
//              12'd301 : data <= 32'h811FDCA1;
//              12'd302 : data <= 32'h811FF62C;
//              12'd303 : data <= 32'h811F53A7;
//              12'd304 : data <= 32'h811F4204;
//              12'd305 : data <= 32'h811F9CEA;
//              12'd306 : data <= 32'h811F2FC5;
//              12'd307 : data <= 32'h811FCFEB;
//              12'd308 : data <= 32'h8110C589;
//              12'd309 : data <= 32'h81108081;
//              12'd310 : data <= 32'h8110ABFF;
//              12'd311 : data <= 32'h8110FE6A;
//              12'd312 : data <= 32'h81105CE2;
//              12'd313 : data <= 32'h81102016;
//              12'd314 : data <= 32'h81106CD1;
//              12'd315 : data <= 32'h811068EB;
//              12'd316 : data <= 32'h81107F6E;
//              12'd317 : data <= 32'h81104401;
//              12'd318 : data <= 32'h81108590;
//              12'd319 : data <= 32'h811080A1;
//              12'd320 : data <= 32'h811032A0;
//              12'd321 : data <= 32'h81100088;
//              12'd322 : data <= 32'h81107206;
//              12'd323 : data <= 32'h8110D706;
//              12'd324 : data <= 32'h8110ADF9;
//              12'd325 : data <= 32'h811088F9;
//              12'd326 : data <= 32'h81106027;
//              12'd327 : data <= 32'h8110CD91;
//              12'd328 : data <= 32'h81108695;
//              12'd329 : data <= 32'h8110AF05;
//              12'd330 : data <= 32'h811029D9;
//              12'd331 : data <= 32'h8110386B;
//              12'd332 : data <= 32'h81106B44;
//              12'd333 : data <= 32'h8110BDD3;
//              12'd334 : data <= 32'h811084EB;
//              12'd335 : data <= 32'h811080A7;
//              12'd336 : data <= 32'h81103468;
//              12'd337 : data <= 32'h8110162F;
//              12'd338 : data <= 32'h811080A6;
//              12'd339 : data <= 32'h81102204;
//              12'd340 : data <= 32'h8110312F;
//              12'd341 : data <= 32'h8110D5FA;
//              12'd342 : data <= 32'h81104866;
//              12'd343 : data <= 32'h8110E64F;
//              12'd344 : data <= 32'h81219859;
//              12'd345 : data <= 32'h81215047;
//              12'd346 : data <= 32'h81211C26;
//              12'd347 : data <= 32'h8121940C;
//              12'd348 : data <= 32'h8121C6BE;
//              12'd349 : data <= 32'h8121FFFE;
//              12'd350 : data <= 32'h8121C4B1;
//              12'd351 : data <= 32'h812188B9;
//              12'd352 : data <= 32'h8121F61A;
//              12'd353 : data <= 32'h8121CF4A;
//              12'd354 : data <= 32'h812188B9;
//              12'd355 : data <= 32'h8121A8BD;
//              12'd356 : data <= 32'h81214B50;
//              12'd357 : data <= 32'h81217AF9;
//              12'd358 : data <= 32'h81217266;
//              12'd359 : data <= 32'h81215766;
//              12'd360 : data <= 32'h8121EF4C;
//              12'd361 : data <= 32'h81218CBB;
//              12'd362 : data <= 32'h8121BBF2;
//              12'd363 : data <= 32'h8121022B;
//              12'd364 : data <= 32'h81219226;
//              12'd365 : data <= 32'h8121D206;
//              12'd366 : data <= 32'h81215704;
//              12'd367 : data <= 32'h8121EE49;
//              12'd368 : data <= 32'h812110B4;
//              12'd369 : data <= 32'h8121C327;
//              12'd370 : data <= 32'h81218E1D;
//              12'd371 : data <= 32'h81218785;
//              12'd372 : data <= 32'h81212084;
//              12'd373 : data <= 32'h81213327;
//              12'd374 : data <= 32'h8121C858;
//              12'd375 : data <= 32'h812122C4;
//              12'd376 : data <= 32'h812169D1;
//              12'd377 : data <= 32'h81219C58;
//              12'd378 : data <= 32'h8121BEFE;
//              12'd379 : data <= 32'h8121AEBC;
//              12'd380 : data <= 32'h8116B964;
//              12'd381 : data <= 32'h81167F7B;
//              12'd382 : data <= 32'h8116F1BB;
//              12'd383 : data <= 32'h811691D9;
//              12'd384 : data <= 32'h8116A9DD;
//              12'd385 : data <= 32'h8116434A;
//              12'd386 : data <= 32'h8116B9C6;
//              12'd387 : data <= 32'h81163F40;
//              12'd388 : data <= 32'h811615D3;
//              12'd389 : data <= 32'h811600BF;
//              12'd390 : data <= 32'h81167A06;
//              12'd391 : data <= 32'h8116ED42;
//              12'd392 : data <= 32'h811618FF;
//              12'd393 : data <= 32'h81168504;
//              12'd394 : data <= 32'h81168DD9;
//              12'd395 : data <= 32'h811688B9;
//              12'd396 : data <= 32'h81168007;
//              12'd397 : data <= 32'h81167704;
//              12'd398 : data <= 32'h81168111;
//              12'd399 : data <= 32'h81167DE4;
//              12'd400 : data <= 32'h81167DD9;
//              12'd401 : data <= 32'h811638FB;
//              12'd402 : data <= 32'h81163EF7;
//              12'd403 : data <= 32'h811690B4;
//              12'd404 : data <= 32'h81165AD3;
//              12'd405 : data <= 32'h81163CC8;
//              12'd406 : data <= 32'h811630E0;
//              12'd407 : data <= 32'h81167C7A;
//              12'd408 : data <= 32'h81165D7A;
//              12'd409 : data <= 32'h81168EE5;
//              12'd410 : data <= 32'h81163BA7;
//              12'd411 : data <= 32'h8116DF7F;
//              12'd412 : data <= 32'h8116EF7E;
//              12'd413 : data <= 32'h81166387;
//              12'd414 : data <= 32'h81165022;
//              12'd415 : data <= 32'h8116188B;
//              12'd416 : data <= 32'h811F3D7E;
//              12'd417 : data <= 32'h811FEF5A;
//              12'd418 : data <= 32'h811FF191;
//              12'd419 : data <= 32'h811F71B9;
//              12'd420 : data <= 32'h811FA6DB;
//              12'd421 : data <= 32'h811FC800;
//              12'd422 : data <= 32'h811FBACE;
//              12'd423 : data <= 32'h811F7F46;
//              12'd424 : data <= 32'h811F0D99;
//              12'd425 : data <= 32'h811F20BF;
//              12'd426 : data <= 32'h811F7B04;
//              12'd427 : data <= 32'h811FFF40;
//              12'd428 : data <= 32'h811F58BF;
//              12'd429 : data <= 32'h811FC504;
//              12'd430 : data <= 32'h811F8DB8;
//              12'd431 : data <= 32'h811F08B9;
//              12'd432 : data <= 32'h811F02A7;
//              12'd433 : data <= 32'h811F7F24;
//              12'd434 : data <= 32'h811F85DD;
//              12'd435 : data <= 32'h811FF9F4;
//              12'd436 : data <= 32'h811F7DD9;
//              12'd437 : data <= 32'h811F39FB;
//              12'd438 : data <= 32'h811FDCF7;
//              12'd439 : data <= 32'h811FB3B4;
//              12'd440 : data <= 32'h811FA0A1;
//              12'd441 : data <= 32'h811F294D;
//              12'd442 : data <= 32'h811F70C0;
//              12'd443 : data <= 32'h811F787A;
//              12'd444 : data <= 32'h811F4F4A;
//              12'd445 : data <= 32'h811F43B8;
//              12'd446 : data <= 32'h811FBEF7;
//              12'd447 : data <= 32'h811FDF6A;
//              12'd448 : data <= 32'h811FEF7B;
//              12'd449 : data <= 32'h811FE3A7;
//              12'd450 : data <= 32'h811FF222;
//              12'd451 : data <= 32'h811F5002;
//              12'd452 : data <= 32'h811840A3;
//              12'd453 : data <= 32'h81187D66;
//              12'd454 : data <= 32'h8118FB56;
//              12'd455 : data <= 32'h8118EF6A;
//              12'd456 : data <= 32'h811855D1;
//              12'd457 : data <= 32'h8118AFD3;
//              12'd458 : data <= 32'h81184700;
//              12'd459 : data <= 32'h81184087;
//              12'd460 : data <= 32'h81184A42;
//              12'd461 : data <= 32'h8118F5B6;
//              12'd462 : data <= 32'h8118B6A8;
//              12'd463 : data <= 32'h81182CF1;
//              12'd464 : data <= 32'h81188120;
//              12'd465 : data <= 32'h81187012;
//              12'd466 : data <= 32'h81187366;
//              12'd467 : data <= 32'h8118DF6E;
//              12'd468 : data <= 32'h8118A8D1;
//              12'd469 : data <= 32'h81184010;
//              12'd470 : data <= 32'h811878A2;
//              12'd471 : data <= 32'h8118E202;
//              12'd472 : data <= 32'h8118122E;
//              12'd473 : data <= 32'h81184204;
//              12'd474 : data <= 32'h81183246;
//              12'd475 : data <= 32'h81187646;
//              12'd476 : data <= 32'h8118F306;
//              12'd477 : data <= 32'h8118DFCF;
//              12'd478 : data <= 32'h811882EF;
//              12'd479 : data <= 32'h8118122E;
//              12'd480 : data <= 32'h8118D76E;
//              12'd481 : data <= 32'h8118C7BD;
//              12'd482 : data <= 32'h8118C118;
//              12'd483 : data <= 32'h8118D53A;
//              12'd484 : data <= 32'h8118842B;
//              12'd485 : data <= 32'h81181204;
//              12'd486 : data <= 32'h8118F300;
//              12'd487 : data <= 32'h8118193B;
//              12'd488 : data <= 32'h811BFF74;
//              12'd489 : data <= 32'h811B0E7B;
//              12'd490 : data <= 32'h811B8DF9;
//              12'd491 : data <= 32'h811B2DF9;
//              12'd492 : data <= 32'h811B2F7F;
//              12'd493 : data <= 32'h811B1F20;
//              12'd494 : data <= 32'h811B82EE;
//              12'd495 : data <= 32'h811B3542;
//              12'd496 : data <= 32'h811B0DB1;
//              12'd497 : data <= 32'h811B22BB;
//              12'd498 : data <= 32'h811B7642;
//              12'd499 : data <= 32'h811BEF57;
//              12'd500 : data <= 32'h811B10BF;
//              12'd501 : data <= 32'h811B0586;
//              12'd502 : data <= 32'h811B8DD9;
//              12'd503 : data <= 32'h811B28D1;
//              12'd504 : data <= 32'h811B8225;
//              12'd505 : data <= 32'h811B6B4E;
//              12'd506 : data <= 32'h811B848B;
//              12'd507 : data <= 32'h811B5CFC;
//              12'd508 : data <= 32'h811B7D51;
//              12'd509 : data <= 32'h811B39FB;
//              12'd510 : data <= 32'h811B6C73;
//              12'd511 : data <= 32'h811BB094;
//              12'd512 : data <= 32'h811B029B;
//              12'd513 : data <= 32'h811B2440;
//              12'd514 : data <= 32'h811B30A2;
//              12'd515 : data <= 32'h811B705A;
//              12'd516 : data <= 32'h811B7F7F;
//              12'd517 : data <= 32'h811B8AED;
//              12'd518 : data <= 32'h811B3966;
//              12'd519 : data <= 32'h811BDF7B;
//              12'd520 : data <= 32'h811B1F73;
//              12'd521 : data <= 32'h811B7307;
//              12'd522 : data <= 32'h811B1821;
//              12'd523 : data <= 32'h811B2401;
//              12'd524 : data <= 32'h81198081;
//              12'd525 : data <= 32'h811912E7;
//              12'd526 : data <= 32'h8119796E;
//              12'd527 : data <= 32'h8119FF3C;
//              12'd528 : data <= 32'h81195CA0;
//              12'd529 : data <= 32'h81193624;
//              12'd530 : data <= 32'h8119C809;
//              12'd531 : data <= 32'h8119A8F3;
//              12'd532 : data <= 32'h811918D9;
//              12'd533 : data <= 32'h81195F6A;
//              12'd534 : data <= 32'h81198950;
//              12'd535 : data <= 32'h81198C54;
//              12'd536 : data <= 32'h81197DCB;
//              12'd537 : data <= 32'h81197DD9;
//              12'd538 : data <= 32'h811932AF;
//              12'd539 : data <= 32'h81197766;
//              12'd540 : data <= 32'h81195EC4;
//              12'd541 : data <= 32'h81198100;
//              12'd542 : data <= 32'h81192206;
//              12'd543 : data <= 32'h81197A04;
//              12'd544 : data <= 32'h8119C60E;
//              12'd545 : data <= 32'h81198604;
//              12'd546 : data <= 32'h81198606;
//              12'd547 : data <= 32'h8119C562;
//              12'd548 : data <= 32'h8119B4BE;
//              12'd549 : data <= 32'h8119CF7D;
//              12'd550 : data <= 32'h811982A7;
//              12'd551 : data <= 32'h8119E3DF;
//              12'd552 : data <= 32'h8119252D;
//              12'd553 : data <= 32'h8119B9A8;
//              12'd554 : data <= 32'h81192DF9;
//              12'd555 : data <= 32'h81192815;
//              12'd556 : data <= 32'h81193583;
//              12'd557 : data <= 32'h811978A6;
//              12'd558 : data <= 32'h81195D48;
//              12'd559 : data <= 32'h8119A514;
//              12'd560 : data <= 32'h8120FB46;
//              12'd561 : data <= 32'h81207F49;
//              12'd562 : data <= 32'h81206BFA;
//              12'd563 : data <= 32'h8120F4FE;
//              12'd564 : data <= 32'h8120502D;
//              12'd565 : data <= 32'h81204D00;
//              12'd566 : data <= 32'h81200124;
//              12'd567 : data <= 32'h81200940;
//              12'd568 : data <= 32'h8120AFC0;
//              12'd569 : data <= 32'h8120A5BB;
//              12'd570 : data <= 32'h8120D22E;
//              12'd571 : data <= 32'h81206512;
//              12'd572 : data <= 32'h8120A88F;
//              12'd573 : data <= 32'h812053AE;
//              12'd574 : data <= 32'h8120CDFD;
//              12'd575 : data <= 32'h8120ADF9;
//              12'd576 : data <= 32'h8120CB36;
//              12'd577 : data <= 32'h812073FF;
//              12'd578 : data <= 32'h81206EE9;
//              12'd579 : data <= 32'h8120A5CC;
//              12'd580 : data <= 32'h81202DF9;
//              12'd581 : data <= 32'h812039F9;
//              12'd582 : data <= 32'h81206D50;
//              12'd583 : data <= 32'h8120A898;
//              12'd584 : data <= 32'h8120D626;
//              12'd585 : data <= 32'h81207555;
//              12'd586 : data <= 32'h812079D0;
//              12'd587 : data <= 32'h812038A1;
//              12'd588 : data <= 32'h81206900;
//              12'd589 : data <= 32'h81204502;
//              12'd590 : data <= 32'h8120EF4E;
//              12'd591 : data <= 32'h8120DED7;
//              12'd592 : data <= 32'h8120C870;
//              12'd593 : data <= 32'h812036AF;
//              12'd594 : data <= 32'h8120502E;
//              12'd595 : data <= 32'h8120C000;
//              12'd596 : data <= 32'h811B3326;
//              12'd597 : data <= 32'h811B8D1D;
//              12'd598 : data <= 32'h811BAA99;
//              12'd599 : data <= 32'h811B09A1;
//              12'd600 : data <= 32'h811B2424;
//              12'd601 : data <= 32'h811B4342;
//              12'd602 : data <= 32'h811BA946;
//              12'd603 : data <= 32'h811B5782;
//              12'd604 : data <= 32'h811B4304;
//              12'd605 : data <= 32'h811BD74E;
//              12'd606 : data <= 32'h811B5ADF;
//              12'd607 : data <= 32'h811BFA65;
//              12'd608 : data <= 32'h811B7A06;
//              12'd609 : data <= 32'h811B8508;
//              12'd610 : data <= 32'h811B85B1;
//              12'd611 : data <= 32'h811BA091;
//              12'd612 : data <= 32'h811B7716;
//              12'd613 : data <= 32'h811B7FFD;
//              12'd614 : data <= 32'h811B1224;
//              12'd615 : data <= 32'h811BC540;
//              12'd616 : data <= 32'h811BEDD9;
//              12'd617 : data <= 32'h811B88FB;
//              12'd618 : data <= 32'h811B8396;
//              12'd619 : data <= 32'h811B57BC;
//              12'd620 : data <= 32'h811BC6AE;
//              12'd621 : data <= 32'h811BED30;
//              12'd622 : data <= 32'h811B39D1;
//              12'd623 : data <= 32'h811BB0BB;
//              12'd624 : data <= 32'h811BA9D9;
//              12'd625 : data <= 32'h811BBEFE;
//              12'd626 : data <= 32'h811B8DF9;
//              12'd627 : data <= 32'h811BC9DE;
//              12'd628 : data <= 32'h811B3940;
//              12'd629 : data <= 32'h811B3C03;
//              12'd630 : data <= 32'h811B322F;
//              12'd631 : data <= 32'h811B3E7D;
//              12'd632 : data <= 32'h81277E56;
//              12'd633 : data <= 32'h8127460E;
//              12'd634 : data <= 32'h81270D10;
//              12'd635 : data <= 32'h8127A57A;
//              12'd636 : data <= 32'h8127B2B7;
//              12'd637 : data <= 32'h81278FC0;
//              12'd638 : data <= 32'h81277126;
//              12'd639 : data <= 32'h81274304;
//              12'd640 : data <= 32'h81270B84;
//              12'd641 : data <= 32'h8127AD73;
//              12'd642 : data <= 32'h8127AD81;
//              12'd643 : data <= 32'h8127ACFB;
//              12'd644 : data <= 32'h812799A4;
//              12'd645 : data <= 32'h81279287;
//              12'd646 : data <= 32'h81274514;
//              12'd647 : data <= 32'h8127AD90;
//              12'd648 : data <= 32'h812709F3;
//              12'd649 : data <= 32'h812738ED;
//              12'd650 : data <= 32'h8127C5FD;
//              12'd651 : data <= 32'h812780E9;
//              12'd652 : data <= 32'h8127B9F3;
//              12'd653 : data <= 32'h812779DB;
//              12'd654 : data <= 32'h812779FA;
//              12'd655 : data <= 32'h81271484;
//              12'd656 : data <= 32'h81273A59;
//              12'd657 : data <= 32'h812730D9;
//              12'd658 : data <= 32'h8127BDD9;
//              12'd659 : data <= 32'h812700A9;
//              12'd660 : data <= 32'h8127CB18;
//              12'd661 : data <= 32'h812706A6;
//              12'd662 : data <= 32'h81279F06;
//              12'd663 : data <= 32'h81277AE3;
//              12'd664 : data <= 32'h81276A4E;
//              12'd665 : data <= 32'h8127BDBB;
//              12'd666 : data <= 32'h8127B0BF;
//              12'd667 : data <= 32'h8127C502;
//              12'd668 : data <= 32'h8121F1AB;
//              12'd669 : data <= 32'h81210E04;
//              12'd670 : data <= 32'h81218D2E;
//              12'd671 : data <= 32'h81210A04;
//              12'd672 : data <= 32'h8121C55C;
//              12'd673 : data <= 32'h812128FB;
//              12'd674 : data <= 32'h81214768;
//              12'd675 : data <= 32'h8121C591;
//              12'd676 : data <= 32'h8121E090;
//              12'd677 : data <= 32'h8121724C;
//              12'd678 : data <= 32'h81212D58;
//              12'd679 : data <= 32'h8121FFFB;
//              12'd680 : data <= 32'h8121734E;
//              12'd681 : data <= 32'h8121EDF9;
//              12'd682 : data <= 32'h812190AB;
//              12'd683 : data <= 32'h8121823D;
//              12'd684 : data <= 32'h8121ABD4;
//              12'd685 : data <= 32'h8121DEF9;
//              12'd686 : data <= 32'h81217A44;
//              12'd687 : data <= 32'h81216F40;
//              12'd688 : data <= 32'h8121CE1B;
//              12'd689 : data <= 32'h81218FFF;
//              12'd690 : data <= 32'h8121ACF5;
//              12'd691 : data <= 32'h8121EF4B;
//              12'd692 : data <= 32'h8121C5A0;
//              12'd693 : data <= 32'h8121C33F;
//              12'd694 : data <= 32'h8121879C;
//              12'd695 : data <= 32'h8121FA95;
//              12'd696 : data <= 32'h81213010;
//              12'd697 : data <= 32'h8121FC53;
//              12'd698 : data <= 32'h8121CFF9;
//              12'd699 : data <= 32'h81210605;
//              12'd700 : data <= 32'h8121ECEF;
//              12'd701 : data <= 32'h81215A74;
//              12'd702 : data <= 32'h81213F46;
//              12'd703 : data <= 32'h81215204;
//              12'd704 : data <= 32'h811A1174;
//              12'd705 : data <= 32'h811A3BFA;
//              12'd706 : data <= 32'h811AB7B7;
//              12'd707 : data <= 32'h811AB0F9;
//              12'd708 : data <= 32'h811AABDD;
//              12'd709 : data <= 32'h811ADFEF;
//              12'd710 : data <= 32'h811A3BE4;
//              12'd711 : data <= 32'h811A7D86;
//              12'd712 : data <= 32'h811A0CF3;
//              12'd713 : data <= 32'h811AB09F;
//              12'd714 : data <= 32'h811A740B;
//              12'd715 : data <= 32'h811A672E;
//              12'd716 : data <= 32'h811A33AF;
//              12'd717 : data <= 32'h811A8565;
//              12'd718 : data <= 32'h811A8DD9;
//              12'd719 : data <= 32'h811A2891;
//              12'd720 : data <= 32'h811A2020;
//              12'd721 : data <= 32'h811A7FBE;
//              12'd722 : data <= 32'h811A2155;
//              12'd723 : data <= 32'h811AF4D6;
//              12'd724 : data <= 32'h811A7DD1;
//              12'd725 : data <= 32'h811A39FB;
//              12'd726 : data <= 32'h811A6CFB;
//              12'd727 : data <= 32'h811A9886;
//              12'd728 : data <= 32'h811A58BB;
//              12'd729 : data <= 32'h811A2580;
//              12'd730 : data <= 32'h811A3860;
//              12'd731 : data <= 32'h811A786A;
//              12'd732 : data <= 32'h811ADD1A;
//              12'd733 : data <= 32'h811AC337;
//              12'd734 : data <= 32'h811A34E6;
//              12'd735 : data <= 32'h811AD7EA;
//              12'd736 : data <= 32'h811ACF5F;
//              12'd737 : data <= 32'h811A4B55;
//              12'd738 : data <= 32'h811AC311;
//              12'd739 : data <= 32'h811A4123;
//              12'd740 : data <= 32'h811F85F9;
//              12'd741 : data <= 32'h811FF65B;
//              12'd742 : data <= 32'h811FF9DF;
//              12'd743 : data <= 32'h811FEF5A;
//              12'd744 : data <= 32'h811FF5F3;
//              12'd745 : data <= 32'h811F8DD3;
//              12'd746 : data <= 32'h811FC6B1;
//              12'd747 : data <= 32'h811F8801;
//              12'd748 : data <= 32'h811F482E;
//              12'd749 : data <= 32'h811F0F5C;
//              12'd750 : data <= 32'h811F8E08;
//              12'd751 : data <= 32'h811F8899;
//              12'd752 : data <= 32'h811FFF00;
//              12'd753 : data <= 32'h811F7853;
//              12'd754 : data <= 32'h811F7246;
//              12'd755 : data <= 32'h811FF746;
//              12'd756 : data <= 32'h811F38DB;
//              12'd757 : data <= 32'h811F3450;
//              12'd758 : data <= 32'h811F7909;
//              12'd759 : data <= 32'h811FB022;
//              12'd760 : data <= 32'h811F922E;
//              12'd761 : data <= 32'h811F5704;
//              12'd762 : data <= 32'h811FF2EF;
//              12'd763 : data <= 32'h811F5264;
//              12'd764 : data <= 32'h811F6228;
//              12'd765 : data <= 32'h811F72C3;
//              12'd766 : data <= 32'h811F864E;
//              12'd767 : data <= 32'h811F52B6;
//              12'd768 : data <= 32'h811F940E;
//              12'd769 : data <= 32'h811F8F5D;
//              12'd770 : data <= 32'h811FF4BC;
//              12'd771 : data <= 32'h811F0411;
//              12'd772 : data <= 32'h811F8799;
//              12'd773 : data <= 32'h811FC254;
//              12'd774 : data <= 32'h811FE040;
//              12'd775 : data <= 32'h811F60D2;
//              12'd776 : data <= 32'h81124D01;
//              12'd777 : data <= 32'h811210EA;
//              12'd778 : data <= 32'h81124224;
//              12'd779 : data <= 32'h81128622;
//              12'd780 : data <= 32'h81120081;
//              12'd781 : data <= 32'h81120444;
//              12'd782 : data <= 32'h81124508;
//              12'd783 : data <= 32'h8112C4F1;
//              12'd784 : data <= 32'h8112D32F;
//              12'd785 : data <= 32'h81125A40;
//              12'd786 : data <= 32'h8112C606;
//              12'd787 : data <= 32'h8112FFF1;
//              12'd788 : data <= 32'h811284B9;
//              12'd789 : data <= 32'h8112B09A;
//              12'd790 : data <= 32'h811272A6;
//              12'd791 : data <= 32'h8112D72E;
//              12'd792 : data <= 32'h8112D734;
//              12'd793 : data <= 32'h8112C59B;
//              12'd794 : data <= 32'h8112EE99;
//              12'd795 : data <= 32'h81124148;
//              12'd796 : data <= 32'h811282AD;
//              12'd797 : data <= 32'h8112879C;
//              12'd798 : data <= 32'h81128FC1;
//              12'd799 : data <= 32'h8112A95A;
//              12'd800 : data <= 32'h81123C56;
//              12'd801 : data <= 32'h8112E659;
//              12'd802 : data <= 32'h81124F9F;
//              12'd803 : data <= 32'h81128DB9;
//              12'd804 : data <= 32'h811273E4;
//              12'd805 : data <= 32'h81124402;
//              12'd806 : data <= 32'h81122A77;
//              12'd807 : data <= 32'h8112E3BE;
//              12'd808 : data <= 32'h8112D582;
//              12'd809 : data <= 32'h811271A6;
//              12'd810 : data <= 32'h8112546E;
//              12'd811 : data <= 32'h8112866E;
//              12'd812 : data <= 32'h811BB01C;
//              12'd813 : data <= 32'h811B2B02;
//              12'd814 : data <= 32'h811B8854;
//              12'd815 : data <= 32'h811B6838;
//              12'd816 : data <= 32'h811B0281;
//              12'd817 : data <= 32'h811BC342;
//              12'd818 : data <= 32'h811B4100;
//              12'd819 : data <= 32'h811B186A;
//              12'd820 : data <= 32'h811BC380;
//              12'd821 : data <= 32'h811BFFFB;
//              12'd822 : data <= 32'h811B38C3;
//              12'd823 : data <= 32'h811B7944;
//              12'd824 : data <= 32'h811B7A2E;
//              12'd825 : data <= 32'h811B4D40;
//              12'd826 : data <= 32'h811B08D0;
//              12'd827 : data <= 32'h811B2DD1;
//              12'd828 : data <= 32'h811B54AB;
//              12'd829 : data <= 32'h811B5204;
//              12'd830 : data <= 32'h811B3026;
//              12'd831 : data <= 32'h811BD204;
//              12'd832 : data <= 32'h811B7D7A;
//              12'd833 : data <= 32'h811B90C1;
//              12'd834 : data <= 32'h811B6652;
//              12'd835 : data <= 32'h811B55CE;
//              12'd836 : data <= 32'h811B4046;
//              12'd837 : data <= 32'h811BCDD8;
//              12'd838 : data <= 32'h811B31E9;
//              12'd839 : data <= 32'h811B031A;
//              12'd840 : data <= 32'h811B7BEA;
//              12'd841 : data <= 32'h811B169C;
//              12'd842 : data <= 32'h811B21A0;
//              12'd843 : data <= 32'h811B7C45;
//              12'd844 : data <= 32'h811B1F7A;
//              12'd845 : data <= 32'h811B302F;
//              12'd846 : data <= 32'h811BC92C;
//              12'd847 : data <= 32'h811B9CE7;
//              12'd848 : data <= 32'h811D0059;
//              12'd849 : data <= 32'h811DFEB0;
//              12'd850 : data <= 32'h811DFDF3;
//              12'd851 : data <= 32'h811D3A95;
//              12'd852 : data <= 32'h811D0D40;
//              12'd853 : data <= 32'h811DCABB;
//              12'd854 : data <= 32'h811D39D7;
//              12'd855 : data <= 32'h811D7766;
//              12'd856 : data <= 32'h811DDFFF;
//              12'd857 : data <= 32'h811D339F;
//              12'd858 : data <= 32'h811DD320;
//              12'd859 : data <= 32'h811DF61F;
//              12'd860 : data <= 32'h811DC7AF;
//              12'd861 : data <= 32'h811D0704;
//              12'd862 : data <= 32'h811D89F8;
//              12'd863 : data <= 32'h811DA8B1;
//              12'd864 : data <= 32'h811DC202;
//              12'd865 : data <= 32'h811D2EDD;
//              12'd866 : data <= 32'h811D8940;
//              12'd867 : data <= 32'h811DA5B7;
//              12'd868 : data <= 32'h811D7BD3;
//              12'd869 : data <= 32'h811D505B;
//              12'd870 : data <= 32'h811D7B55;
//              12'd871 : data <= 32'h811D7861;
//              12'd872 : data <= 32'h811D05BB;
//              12'd873 : data <= 32'h811D070C;
//              12'd874 : data <= 32'h811DB0E3;
//              12'd875 : data <= 32'h811DF34A;
//              12'd876 : data <= 32'h811DFB3A;
//              12'd877 : data <= 32'h811D4371;
//              12'd878 : data <= 32'h811D72A6;
//              12'd879 : data <= 32'h811DD72E;
//              12'd880 : data <= 32'h811DC51E;
//              12'd881 : data <= 32'h811D6305;
//              12'd882 : data <= 32'h811D1A13;
//              12'd883 : data <= 32'h811D4100;
//              12'd884 : data <= 32'h8127F5CE;
//              12'd885 : data <= 32'h8127766E;
//              12'd886 : data <= 32'h81270426;
//              12'd887 : data <= 32'h8127822E;
//              12'd888 : data <= 32'h8127B286;
//              12'd889 : data <= 32'h8127D550;
//              12'd890 : data <= 32'h81274D79;
//              12'd891 : data <= 32'h81278231;
//              12'd892 : data <= 32'h8127A040;
//              12'd893 : data <= 32'h8127E8C0;
//              12'd894 : data <= 32'h8127AA37;
//              12'd895 : data <= 32'h81277DE5;
//              12'd896 : data <= 32'h81279952;
//              12'd897 : data <= 32'h8127F772;
//              12'd898 : data <= 32'h81277602;
//              12'd899 : data <= 32'h8127570F;
//              12'd900 : data <= 32'h812719EC;
//              12'd901 : data <= 32'h81279842;
//              12'd902 : data <= 32'h8127D6F7;
//              12'd903 : data <= 32'h81270951;
//              12'd904 : data <= 32'h8127800D;
//              12'd905 : data <= 32'h81278EB5;
//              12'd906 : data <= 32'h812780A9;
//              12'd907 : data <= 32'h81278314;
//              12'd908 : data <= 32'h81277E76;
//              12'd909 : data <= 32'h8127FF52;
//              12'd910 : data <= 32'h8127CC14;
//              12'd911 : data <= 32'h81270991;
//              12'd912 : data <= 32'h812784A0;
//              12'd913 : data <= 32'h81270500;
//              12'd914 : data <= 32'h8127CD5D;
//              12'd915 : data <= 32'h8127E9B5;
//              12'd916 : data <= 32'h8127AEC1;
//              12'd917 : data <= 32'h812710C2;
//              12'd918 : data <= 32'h81278CFE;
//              12'd919 : data <= 32'h8127AFFF;
//              12'd920 : data <= 32'h811BB2DE;
//              12'd921 : data <= 32'h811BF5A7;
//              12'd922 : data <= 32'h811BDBBB;
//              12'd923 : data <= 32'h811BBBDB;
//              12'd924 : data <= 32'h811B796A;
//              12'd925 : data <= 32'h811B782F;
//              12'd926 : data <= 32'h811B3EF7;
//              12'd927 : data <= 32'h811BFF65;
//              12'd928 : data <= 32'h811B8FD9;
//              12'd929 : data <= 32'h811B28E9;
//              12'd930 : data <= 32'h811BD00E;
//              12'd931 : data <= 32'h811B8222;
//              12'd932 : data <= 32'h811B4C16;
//              12'd933 : data <= 32'h811B85EA;
//              12'd934 : data <= 32'h811B8DD9;
//              12'd935 : data <= 32'h811B28FB;
//              12'd936 : data <= 32'h811B5616;
//              12'd937 : data <= 32'h811BB7FF;
//              12'd938 : data <= 32'h811BF240;
//              12'd939 : data <= 32'h811BC5D4;
//              12'd940 : data <= 32'h811B3D59;
//              12'd941 : data <= 32'h811B39F9;
//              12'd942 : data <= 32'h811B6B99;
//              12'd943 : data <= 32'h811B2C7D;
//              12'd944 : data <= 32'h811B52A5;
//              12'd945 : data <= 32'h811B540A;
//              12'd946 : data <= 32'h811B7A00;
//              12'd947 : data <= 32'h811B7C40;
//              12'd948 : data <= 32'h811BFCDA;
//              12'd949 : data <= 32'h811B5006;
//              12'd950 : data <= 32'h811BD088;
//              12'd951 : data <= 32'h811B1246;
//              12'd952 : data <= 32'h811BC315;
//              12'd953 : data <= 32'h811BE767;
//              12'd954 : data <= 32'h811BEB95;
//              12'd955 : data <= 32'h811B730E;
//              12'd956 : data <= 32'h812BE593;
//              12'd957 : data <= 32'h812B5824;
//              12'd958 : data <= 32'h812B8580;
//              12'd959 : data <= 32'h812BD2EE;
//              12'd960 : data <= 32'h812B72AF;
//              12'd961 : data <= 32'h812B7444;
//              12'd962 : data <= 32'h812B5CF9;
//              12'd963 : data <= 32'h812BC73F;
//              12'd964 : data <= 32'h812B30F9;
//              12'd965 : data <= 32'h812B7ACA;
//              12'd966 : data <= 32'h812B8C7E;
//              12'd967 : data <= 32'h812BD324;
//              12'd968 : data <= 32'h812B5708;
//              12'd969 : data <= 32'h812B3CF6;
//              12'd970 : data <= 32'h812B7726;
//              12'd971 : data <= 32'h812BD74E;
//              12'd972 : data <= 32'h812B17FD;
//              12'd973 : data <= 32'h812BCC63;
//              12'd974 : data <= 32'h812BF2AE;
//              12'd975 : data <= 32'h812B5A08;
//              12'd976 : data <= 32'h812B802D;
//              12'd977 : data <= 32'h812B8F24;
//              12'd978 : data <= 32'h812B80C9;
//              12'd979 : data <= 32'h812B8F95;
//              12'd980 : data <= 32'h812B40A9;
//              12'd981 : data <= 32'h812BCBB1;
//              12'd982 : data <= 32'h812B0711;
//              12'd983 : data <= 32'h812B8895;
//              12'd984 : data <= 32'h812BA491;
//              12'd985 : data <= 32'h812B7860;
//              12'd986 : data <= 32'h812B4FB9;
//              12'd987 : data <= 32'h812B60B1;
//              12'd988 : data <= 32'h812B94D0;
//              12'd989 : data <= 32'h812BB8D1;
//              12'd990 : data <= 32'h812B28EF;
//              12'd991 : data <= 32'h812B062E;
//              12'd992 : data <= 32'h81228201;
//              12'd993 : data <= 32'h81228810;
//              12'd994 : data <= 32'h81228448;
//              12'd995 : data <= 32'h8122FBF7;
//              12'd996 : data <= 32'h812219ED;
//              12'd997 : data <= 32'h81221004;
//              12'd998 : data <= 32'h8122CF8B;
//              12'd999 : data <= 32'h8122E9F9;
//              12'd1000: data <= 32'h812232A9;
//              12'd1001: data <= 32'h8122736C;
//              12'd1002: data <= 32'h8122500C;
//              12'd1003: data <= 32'h81228942;
//              12'd1004: data <= 32'h81227A63;
//              12'd1005: data <= 32'h81227DD9;
//              12'd1006: data <= 32'h812230AE;
//              12'd1007: data <= 32'h8122D726;
//              12'd1008: data <= 32'h81221BEC;
//              12'd1009: data <= 32'h81228802;
//              12'd1010: data <= 32'h812202AF;
//              12'd1011: data <= 32'h81225204;
//              12'd1012: data <= 32'h8122440C;
//              12'd1013: data <= 32'h81228704;
//              12'd1014: data <= 32'h8122AE86;
//              12'd1015: data <= 32'h8122EDD3;
//              12'd1016: data <= 32'h81228418;
//              12'd1017: data <= 32'h8122CA1D;
//              12'd1018: data <= 32'h812287BB;
//              12'd1019: data <= 32'h8122ED59;
//              12'd1020: data <= 32'h812269C1;
//              12'd1021: data <= 32'h8122794A;
//              12'd1022: data <= 32'h8122EFB9;
//              12'd1023: data <= 32'h81220891;
//              12'd1024: data <= 32'h81221182;
//              12'd1025: data <= 32'h81227DBA;
//              12'd1026: data <= 32'h812210AE;
//              12'd1027: data <= 32'h81221204;
//              12'd1028: data <= 32'h8124BFFC;
//              12'd1029: data <= 32'h812409A5;
//              12'd1030: data <= 32'h81248B14;
//              12'd1031: data <= 32'h812490DD;
//              12'd1032: data <= 32'h8124A52C;
//              12'd1033: data <= 32'h81245F68;
//              12'd1034: data <= 32'h8124008C;
//              12'd1035: data <= 32'h81241502;
//              12'd1036: data <= 32'h8124C3D1;
//              12'd1037: data <= 32'h8124B9F7;
//              12'd1038: data <= 32'h81247AF6;
//              12'd1039: data <= 32'h81247F7E;
//              12'd1040: data <= 32'h8124C9B9;
//              12'd1041: data <= 32'h81248CC3;
//              12'd1042: data <= 32'h8124EF7E;
//              12'd1043: data <= 32'h8124CDFB;
//              12'd1044: data <= 32'h8124B710;
//              12'd1045: data <= 32'h81247F24;
//              12'd1046: data <= 32'h8124BF5B;
//              12'd1047: data <= 32'h8124A0FF;
//              12'd1048: data <= 32'h81246A61;
//              12'd1049: data <= 32'h81245042;
//              12'd1050: data <= 32'h81245E69;
//              12'd1051: data <= 32'h81249002;
//              12'd1052: data <= 32'h8124BCF7;
//              12'd1053: data <= 32'h8124DDB9;
//              12'd1054: data <= 32'h812482A6;
//              12'd1055: data <= 32'h812452BE;
//              12'd1056: data <= 32'h81245B10;
//              12'd1057: data <= 32'h81249B4A;
//              12'd1058: data <= 32'h81245946;
//              12'd1059: data <= 32'h8124FF7F;
//              12'd1060: data <= 32'h8124A8FB;
//              12'd1061: data <= 32'h8124E204;
//              12'd1062: data <= 32'h81247006;
//              12'd1063: data <= 32'h81247000;
//              12'd1064: data <= 32'h811F1024;
//              12'd1065: data <= 32'h811FA41E;
//              12'd1066: data <= 32'h811FFAFA;
//              12'd1067: data <= 32'h811FFDF9;
//              12'd1068: data <= 32'h811FF9EB;
//              12'd1069: data <= 32'h811F808B;
//              12'd1070: data <= 32'h811F8348;
//              12'd1071: data <= 32'h811F28D3;
//              12'd1072: data <= 32'h811F0A00;
//              12'd1073: data <= 32'h811F0F14;
//              12'd1074: data <= 32'h811F4D41;
//              12'd1075: data <= 32'h811F8840;
//              12'd1076: data <= 32'h811F7ED1;
//              12'd1077: data <= 32'h811F7F4D;
//              12'd1078: data <= 32'h811F89B9;
//              12'd1079: data <= 32'h811F28D5;
//              12'd1080: data <= 32'h811F69C8;
//              12'd1081: data <= 32'h811F2002;
//              12'd1082: data <= 32'h811F2E0E;
//              12'd1083: data <= 32'h811F7204;
//              12'd1084: data <= 32'h811F7D52;
//              12'd1085: data <= 32'h811F38C3;
//              12'd1086: data <= 32'h811FF486;
//              12'd1087: data <= 32'h811FD7F4;
//              12'd1088: data <= 32'h811F903F;
//              12'd1089: data <= 32'h811FBC7C;
//              12'd1090: data <= 32'h811FFCF0;
//              12'd1091: data <= 32'h811F237E;
//              12'd1092: data <= 32'h811FCB2F;
//              12'd1093: data <= 32'h811F478C;
//              12'd1094: data <= 32'h811F85C9;
//              12'd1095: data <= 32'h811F8851;
//              12'd1096: data <= 32'h811F7B5F;
//              12'd1097: data <= 32'h811F67A3;
//              12'd1098: data <= 32'h811FC48C;
//              12'd1099: data <= 32'h811FBDF1;
//              12'd1100: data <= 32'h81257346;
//              12'd1101: data <= 32'h8125DF1C;
//              12'd1102: data <= 32'h81256258;
//              12'd1103: data <= 32'h81258BF9;
//              12'd1104: data <= 32'h81250481;
//              12'd1105: data <= 32'h81258710;
//              12'd1106: data <= 32'h8125C702;
//              12'd1107: data <= 32'h8125C2B7;
//              12'd1108: data <= 32'h8125375E;
//              12'd1109: data <= 32'h8125FFD7;
//              12'd1110: data <= 32'h812529D0;
//              12'd1111: data <= 32'h81253DD9;
//              12'd1112: data <= 32'h8125B8D1;
//              12'd1113: data <= 32'h81257180;
//              12'd1114: data <= 32'h81257002;
//              12'd1115: data <= 32'h81255746;
//              12'd1116: data <= 32'h81251DEC;
//              12'd1117: data <= 32'h81250920;
//              12'd1118: data <= 32'h81250DFB;
//              12'd1119: data <= 32'h81250FC1;
//              12'd1120: data <= 32'h8125D2AF;
//              12'd1121: data <= 32'h8125F226;
//              12'd1122: data <= 32'h8125D626;
//              12'd1123: data <= 32'h8125D5A2;
//              12'd1124: data <= 32'h8125FDDC;
//              12'd1125: data <= 32'h81251AF3;
//              12'd1126: data <= 32'h81250026;
//              12'd1127: data <= 32'h812587BD;
//              12'd1128: data <= 32'h81254344;
//              12'd1129: data <= 32'h8125124C;
//              12'd1130: data <= 32'h81253A66;
//              12'd1131: data <= 32'h81257F1C;
//              12'd1132: data <= 32'h8125D0A2;
//              12'd1133: data <= 32'h81251CD0;
//              12'd1134: data <= 32'h812504A1;
//              12'd1135: data <= 32'h8125A492;
//              12'd1136: data <= 32'h810F000C;
//              12'd1137: data <= 32'h810FEA58;
//              12'd1138: data <= 32'h810FE092;
//              12'd1139: data <= 32'h810F11E9;
//              12'd1140: data <= 32'h810F2824;
//              12'd1141: data <= 32'h810FF10A;
//              12'd1142: data <= 32'h810FD786;
//              12'd1143: data <= 32'h810F7BDD;
//              12'd1144: data <= 32'h810F1FE7;
//              12'd1145: data <= 32'h810F9637;
//              12'd1146: data <= 32'h810FC6AA;
//              12'd1147: data <= 32'h810F6206;
//              12'd1148: data <= 32'h810F3AD7;
//              12'd1149: data <= 32'h810FD60E;
//              12'd1150: data <= 32'h810F857A;
//              12'd1151: data <= 32'h810F2891;
//              12'd1152: data <= 32'h810F523D;
//              12'd1153: data <= 32'h810F634E;
//              12'd1154: data <= 32'h810F852D;
//              12'd1155: data <= 32'h810F8124;
//              12'd1156: data <= 32'h810FA9F1;
//              12'd1157: data <= 32'h810F08A9;
//              12'd1158: data <= 32'h810F8416;
//              12'd1159: data <= 32'h810FF5F4;
//              12'd1160: data <= 32'h810FED48;
//              12'd1161: data <= 32'h810FBC50;
//              12'd1162: data <= 32'h810F38E1;
//              12'd1163: data <= 32'h810F006A;
//              12'd1164: data <= 32'h810F8FDF;
//              12'd1165: data <= 32'h810FCEFD;
//              12'd1166: data <= 32'h810F2A46;
//              12'd1167: data <= 32'h810FF9E8;
//              12'd1168: data <= 32'h810F376E;
//              12'd1169: data <= 32'h810F062F;
//              12'd1170: data <= 32'h810FE519;
//              12'd1171: data <= 32'h810FADF9;
//              12'd1172: data <= 32'h8123B366;
//              12'd1173: data <= 32'h8123CE2C;
//              12'd1174: data <= 32'h81232199;
//              12'd1175: data <= 32'h812338E5;
//              12'd1176: data <= 32'h8123CF4B;
//              12'd1177: data <= 32'h81238B40;
//              12'd1178: data <= 32'h81233306;
//              12'd1179: data <= 32'h81235F4C;
//              12'd1180: data <= 32'h812309D1;
//              12'd1181: data <= 32'h8123294F;
//              12'd1182: data <= 32'h81237D57;
//              12'd1183: data <= 32'h8123C102;
//              12'd1184: data <= 32'h81231026;
//              12'd1185: data <= 32'h81230000;
//              12'd1186: data <= 32'h81238D38;
//              12'd1187: data <= 32'h8123A8B9;
//              12'd1188: data <= 32'h8123B231;
//              12'd1189: data <= 32'h81232EE7;
//              12'd1190: data <= 32'h8123D60E;
//              12'd1191: data <= 32'h8123D4BB;
//              12'd1192: data <= 32'h812379D1;
//              12'd1193: data <= 32'h81239DDB;
//              12'd1194: data <= 32'h81234999;
//              12'd1195: data <= 32'h81238082;
//              12'd1196: data <= 32'h81235FD4;
//              12'd1197: data <= 32'h81232DD9;
//              12'd1198: data <= 32'h8123B8E1;
//              12'd1199: data <= 32'h812333A1;
//              12'd1200: data <= 32'h8123883B;
//              12'd1201: data <= 32'h81233A31;
//              12'd1202: data <= 32'h8123D209;
//              12'd1203: data <= 32'h812328C0;
//              12'd1204: data <= 32'h81230C5A;
//              12'd1205: data <= 32'h8123AB90;
//              12'd1206: data <= 32'h81232125;
//              12'd1207: data <= 32'h812373FF;
//              12'd1208: data <= 32'h8120FDCB;
//              12'd1209: data <= 32'h812080A5;
//              12'd1210: data <= 32'h8120000D;
//              12'd1211: data <= 32'h81204604;
//              12'd1212: data <= 32'h812081B0;
//              12'd1213: data <= 32'h8120ABD5;
//              12'd1214: data <= 32'h81205F72;
//              12'd1215: data <= 32'h8120EA3F;
//              12'd1216: data <= 32'h812032D6;
//              12'd1217: data <= 32'h81207FDF;
//              12'd1218: data <= 32'h812035F9;
//              12'd1219: data <= 32'h81205AFD;
//              12'd1220: data <= 32'h8120B6E6;
//              12'd1221: data <= 32'h81202A58;
//              12'd1222: data <= 32'h81203202;
//              12'd1223: data <= 32'h81205F4C;
//              12'd1224: data <= 32'h8120BD6B;
//              12'd1225: data <= 32'h8120AE39;
//              12'd1226: data <= 32'h81201D77;
//              12'd1227: data <= 32'h8120DF2D;
//              12'd1228: data <= 32'h8120C22E;
//              12'd1229: data <= 32'h8120E606;
//              12'd1230: data <= 32'h81205607;
//              12'd1231: data <= 32'h81208F5B;
//              12'd1232: data <= 32'h812049C1;
//              12'd1233: data <= 32'h81200BCD;
//              12'd1234: data <= 32'h81208A2D;
//              12'd1235: data <= 32'h8120C7FF;
//              12'd1236: data <= 32'h812043A4;
//              12'd1237: data <= 32'h8120B45B;
//              12'd1238: data <= 32'h8120400A;
//              12'd1239: data <= 32'h8120170E;
//              12'd1240: data <= 32'h81207EBF;
//              12'd1241: data <= 32'h81208CE8;
//              12'd1242: data <= 32'h81209F62;
//              12'd1243: data <= 32'h8120AF95;
//              12'd1244: data <= 32'h811F0222;
//              12'd1245: data <= 32'h811F3564;
//              12'd1246: data <= 32'h811FFB1C;
//              12'd1247: data <= 32'h811F6A46;
//              12'd1248: data <= 32'h811FDD5A;
//              12'd1249: data <= 32'h811F8FFB;
//              12'd1250: data <= 32'h811FD50A;
//              12'd1251: data <= 32'h811FE855;
//              12'd1252: data <= 32'h811FC100;
//              12'd1253: data <= 32'h811F95AA;
//              12'd1254: data <= 32'h811FDBD7;
//              12'd1255: data <= 32'h811F2490;
//              12'd1256: data <= 32'h811F0900;
//              12'd1257: data <= 32'h811F5A00;
//              12'd1258: data <= 32'h811F7766;
//              12'd1259: data <= 32'h811FDF5C;
//              12'd1260: data <= 32'h811FADF9;
//              12'd1261: data <= 32'h811FDFBD;
//              12'd1262: data <= 32'h811FC4A9;
//              12'd1263: data <= 32'h811F121E;
//              12'd1264: data <= 32'h811FCE1E;
//              12'd1265: data <= 32'h811F2F44;
//              12'd1266: data <= 32'h811F7862;
//              12'd1267: data <= 32'h811F7F4F;
//              12'd1268: data <= 32'h811F0F48;
//              12'd1269: data <= 32'h811F4A10;
//              12'd1270: data <= 32'h811FEB5E;
//              12'd1271: data <= 32'h811F00BF;
//              12'd1272: data <= 32'h811F5206;
//              12'd1273: data <= 32'h811FD7DD;
//              12'd1274: data <= 32'h811FC630;
//              12'd1275: data <= 32'h811F6501;
//              12'd1276: data <= 32'h811F19D9;
//              12'd1277: data <= 32'h811FBCBE;
//              12'd1278: data <= 32'h811F73E5;
//              12'd1279: data <= 32'h811FC31A;
//              12'd1280: data <= 32'h812B7442;
//              12'd1281: data <= 32'h812BC32F;
//              12'd1282: data <= 32'h812B00AB;
//              12'd1283: data <= 32'h812B9422;
//              12'd1284: data <= 32'h812BFE8E;
//              12'd1285: data <= 32'h812BB5FF;
//              12'd1286: data <= 32'h812BD76E;
//              12'd1287: data <= 32'h812B88F9;
//              12'd1288: data <= 32'h812B8880;
//              12'd1289: data <= 32'h812BA8B2;
//              12'd1290: data <= 32'h812B22B7;
//              12'd1291: data <= 32'h812B51E3;
//              12'd1292: data <= 32'h812BBB46;
//              12'd1293: data <= 32'h812BFC19;
//              12'd1294: data <= 32'h812BB583;
//              12'd1295: data <= 32'h812B571F;
//              12'd1296: data <= 32'h812BB9DF;
//              12'd1297: data <= 32'h812BFFDB;
//              12'd1298: data <= 32'h812B7F60;
//              12'd1299: data <= 32'h812BE118;
//              12'd1300: data <= 32'h812B94B9;
//              12'd1301: data <= 32'h812B2EED;
//              12'd1302: data <= 32'h812B2C7F;
//              12'd1303: data <= 32'h812B570D;
//              12'd1304: data <= 32'h812BDF16;
//              12'd1305: data <= 32'h812BDE91;
//              12'd1306: data <= 32'h812BEF51;
//              12'd1307: data <= 32'h812B8481;
//              12'd1308: data <= 32'h812B8214;
//              12'd1309: data <= 32'h812BF1B3;
//              12'd1310: data <= 32'h812B8F59;
//              12'd1311: data <= 32'h812B2990;
//              12'd1312: data <= 32'h812B8EFD;
//              12'd1313: data <= 32'h812B8AC2;
//              12'd1314: data <= 32'h812BEF55;
//              12'd1315: data <= 32'h812BBEFF;
//              12'd1316: data <= 32'h812E8F99;
//              12'd1317: data <= 32'h812E2191;
//              12'd1318: data <= 32'h812E0C06;
//              12'd1319: data <= 32'h812E026E;
//              12'd1320: data <= 32'h812E5004;
//              12'd1321: data <= 32'h812E7516;
//              12'd1322: data <= 32'h812EFCFB;
//              12'd1323: data <= 32'h812E42AB;
//              12'd1324: data <= 32'h812E7646;
//              12'd1325: data <= 32'h812ED551;
//              12'd1326: data <= 32'h812E86E9;
//              12'd1327: data <= 32'h812EC2CF;
//              12'd1328: data <= 32'h812EB8BB;
//              12'd1329: data <= 32'h812E503B;
//              12'd1330: data <= 32'h812E9156;
//              12'd1331: data <= 32'h812E8758;
//              12'd1332: data <= 32'h812EA9F9;
//              12'd1333: data <= 32'h812E30B9;
//              12'd1334: data <= 32'h812EDDFB;
//              12'd1335: data <= 32'h812E8591;
//              12'd1336: data <= 32'h812E8BB5;
//              12'd1337: data <= 32'h812E3AC6;
//              12'd1338: data <= 32'h812E34EB;
//              12'd1339: data <= 32'h812E566E;
//              12'd1340: data <= 32'h812E6F44;
//              12'd1341: data <= 32'h812EDBD3;
//              12'd1342: data <= 32'h812E80BF;
//              12'd1343: data <= 32'h812EA4BB;
//              12'd1344: data <= 32'h812E638E;
//              12'd1345: data <= 32'h812E8E37;
//              12'd1346: data <= 32'h812E0304;
//              12'd1347: data <= 32'h812E2E5D;
//              12'd1348: data <= 32'h812E5F6F;
//              12'd1349: data <= 32'h812E9F5E;
//              12'd1350: data <= 32'h812E9E6F;
//              12'd1351: data <= 32'h812ECFDB;
//              12'd1352: data <= 32'h81346BD9;
//              12'd1353: data <= 32'h8134F1B0;
//              12'd1354: data <= 32'h8134D9B5;
//              12'd1355: data <= 32'h8134EF5E;
//              12'd1356: data <= 32'h8134D47C;
//              12'd1357: data <= 32'h81341495;
//              12'd1358: data <= 32'h81347EFB;
//              12'd1359: data <= 32'h8134C23D;
//              12'd1360: data <= 32'h8134E3F9;
//              12'd1361: data <= 32'h81348DFF;
//              12'd1362: data <= 32'h8134CF99;
//              12'd1363: data <= 32'h81348093;
//              12'd1364: data <= 32'h8134A558;
//              12'd1365: data <= 32'h8134FAFF;
//              12'd1366: data <= 32'h81347B4F;
//              12'd1367: data <= 32'h8134FF7A;
//              12'd1368: data <= 32'h8134ACF3;
//              12'd1369: data <= 32'h8134D9FA;
//              12'd1370: data <= 32'h813449BD;
//              12'd1371: data <= 32'h8134BD7B;
//              12'd1372: data <= 32'h813492AF;
//              12'd1373: data <= 32'h81347306;
//              12'd1374: data <= 32'h81347F4A;
//              12'd1375: data <= 32'h81343442;
//              12'd1376: data <= 32'h81341569;
//              12'd1377: data <= 32'h81343BC5;
//              12'd1378: data <= 32'h813484FF;
//              12'd1379: data <= 32'h8134426F;
//              12'd1380: data <= 32'h8134732E;
//              12'd1381: data <= 32'h81344C0C;
//              12'd1382: data <= 32'h81349016;
//              12'd1383: data <= 32'h81346710;
//              12'd1384: data <= 32'h813494AA;
//              12'd1385: data <= 32'h81349DC4;
//              12'd1386: data <= 32'h81348DC3;
//              12'd1387: data <= 32'h81345188;
//              12'd1388: data <= 32'h811A3B5E;
//              12'd1389: data <= 32'h811A6D72;
//              12'd1390: data <= 32'h811A90B9;
//              12'd1391: data <= 32'h811AB8B9;
//              12'd1392: data <= 32'h811A2E43;
//              12'd1393: data <= 32'h811AC8EB;
//              12'd1394: data <= 32'h811A3226;
//              12'd1395: data <= 32'h811A7F04;
//              12'd1396: data <= 32'h811A8DF1;
//              12'd1397: data <= 32'h811A28E7;
//              12'd1398: data <= 32'h811A5A46;
//              12'd1399: data <= 32'h811AA512;
//              12'd1400: data <= 32'h811A28B7;
//              12'd1401: data <= 32'h811A4306;
//              12'd1402: data <= 32'h811A8DD9;
//              12'd1403: data <= 32'h811A28FB;
//              12'd1404: data <= 32'h811A5206;
//              12'd1405: data <= 32'h811A2314;
//              12'd1406: data <= 32'h811ACC48;
//              12'd1407: data <= 32'h811A85EE;
//              12'd1408: data <= 32'h811A7DD1;
//              12'd1409: data <= 32'h811A58FB;
//              12'd1410: data <= 32'h811A6B14;
//              12'd1411: data <= 32'h811A3446;
//              12'd1412: data <= 32'h811A92BF;
//              12'd1413: data <= 32'h811A3458;
//              12'd1414: data <= 32'h811A70E0;
//              12'd1415: data <= 32'h811A756A;
//              12'd1416: data <= 32'h811ACF5A;
//              12'd1417: data <= 32'h811A8BC0;
//              12'd1418: data <= 32'h811A7187;
//              12'd1419: data <= 32'h811ABAFA;
//              12'd1420: data <= 32'h811A162E;
//              12'd1421: data <= 32'h811AD327;
//              12'd1422: data <= 32'h811A5132;
//              12'd1423: data <= 32'h811A5100;
//              12'd1424: data <= 32'h801168F3;
//              12'd1425: data <= 32'h80117C9A;
//              default: data <= 32'h00000000;
//          endcase
//      end

//  endmodule
